xmyoot/smart-bookmark-esp32s3/docs/designBrief.html

# Smart Bookmark voice recorder — rev A

Design brief · press a button, speak, clips sync to a phone over BLE · KiCad 10 · JLCPCB 4-layer + assembly · 2026-10-05

## Status

0 / 0ERC errors / warnings

0 / 0 / 0DRC errors / unconnected / parity

153 / 153datasheet pins verified

37 × 52 mm4-layer, 0.8 mm, parts on one side

about 15 µAstandby, from datasheet figures

builds cleanfirmware, not yet run on hardware

## Board

Top render

Bottom render

Angled render

Top copper

Back side carries no parts: the cell lies in the outlined area; battery pads and test pads sit outside it.

## Architecture

USB-C VBUS --> charger U3 (100 mA) --> +BATT --> regulator U5 --> 3.3 V --> ESP32-S3 module, clip flash U6
                                        |
                        cell + ---------+        cell - --> protection U4/Q1 --> GND

button --> ESP32-S3 <-- PDM microphone (powered from a GPIO)
           ESP32-S3 --> ADPCM clips on flash --> BLE --> phone app

The device sleeps until the button is pressed or USB is plugged in. Holding the button records; on release the clip is stored and the bookmark advertises for 30 s so the phone can fetch it. Protocol: docs/ble_protocol.md.

## Key parts

Ref | Part | LCSC | Role
U1 | ESP32-S3-MINI-1-N8 | C2913206 | MCU + BLE, 8 MB flash, PCB antenna, pre-certified. 15.4 × 20.5 × 2.4 mm
MK1 | TDK T3902 | C3171752 | Bottom-port PDM microphone, powered from GPIO41 so it is fully off in sleep
U6 | W25Q128JVPIQ | C190862 | 16 MB NOR flash for clips, on SPI2
U3 | MCP73832T-2ACI/OT | C38066 | Li-ion charger, 4.20 V, 100 mA set by R3 (10 kΩ)
U4 + Q1 | DW01A + FS8205A | C351410 / C908265 | Cell protection: 4.30 V over-charge, 2.50 V over-discharge, short-circuit
U5 | RT9080-33GJ5 | C841192 | 3.3 V LDO, 600 mA, 2 µA quiescent
J1 + U2 | HRO TYPE-C-31-M-12 + USBLC6-2SC6 | C165948 / C7519 | USB-C: charging, native USB flashing and logs, ESD protection
Q2 + Q3 | AO3401A + 2N7002 | C15127 / C8545 | Battery-sense divider switch: no divider current in sleep
SW1 / D1 | TS-1088-AR02016 / KT-0603R | C720477 / C2286 | Record button (2.0 mm tall) and red status LED

## Pin map

Pin | Function | Note
GPIO1 | Record button | To GND, internal pull-up, wakes the chip. Same pin as the XIAO prototype (D0)
GPIO2 | Status LED | Active high. Same pin as the XIAO prototype (D1)
GPIO5 | Battery voltage | ADC1, half the cell voltage while GPIO16 is high
GPIO16 / 17 / 18 | Battery-sense enable / charging / USB present | USB plug-in can wake the chip
GPIO10–13 | Clip flash U6 | MISO, CS, SCK, MOSI
GPIO19 / 20 | USB D− / D+ | Native USB
GPIO40 / 41 / 42 | Mic data / mic power / mic clock
GPIO0, EN, GPIO43 / 44 | BOOT, reset, UART | Test pads on the back

## Power budget

Item | Current
ESP32-S3 module, deep sleep with wake armed | 8 µA
Regulator U5 | 2 µA
Protection U4 | 3 µA
Flash U6 in deep power-down (to be verified) | about 1 µA
Charger leakage, mic, divider, LED | about 0
Standby total | about 15 µA
Recording (estimate) | about 40 mA
BLE transfer (estimate) | about 80 mA

Ten 20-second clips and one sync a day is roughly 3.5 mAh, so a 150 mAh cell lasts about six weeks of daily use. Standby alone is limited by the cell's self-discharge, not the board.

## Engineering decisions

Topic | Decision
Module, not bare chip | The ESP32-S3-MINI-1 keeps the client's S3 firmware base and hardware PDM decoding, is 2.4 mm tall, and brings its radio certification to a 500-unit run. ESP32-C3/C6 cannot decode a PDM microphone in hardware; nRF52840 would mean rewriting working firmware.
No SD card | Clips are IMA ADPCM (8 kB/s) on flash. That removes the tallest, most power-hungry prototype part and makes BLE sync four times faster than raw audio.
No power-path switch | The load sits on the cell, as on the XIAO. An OR-ing Schottky would leak more in standby than the rest of the board draws. Firmware sleeps when idle on USB so charging can terminate.
Pins chosen for the layout | Each signal group leaves the module on the side its parts sit on, so the top layer has no crossings. Only five signals use the back.
Height, not area, is tight | 0.8 mm board + 2.4 mm module + 2.5 mm cell = 5.7 mm of an assumed 6.0 mm. The USB-C connector is 3.3 mm tall, so the cell is kept clear of it.
Module sits 0.45 mm lower than its outline suggests | The real module is 20.5 mm long; KiCad's footprint draws 20.1 mm. Placed so the real part stays on the board.
Microphone land pattern corrected | The imported footprint had a plated port hole and an unconnected four-piece ground ring. The hole is non-plated and the ring is tied to ground.

## Open items

- Enclosure CAD: every mechanical position (USB-C, button, microphone hole, LED, cell) is an assumption until it arrives.
- Firmware compiles but has never run on hardware. The microphone's left/right slot setting is the likeliest first fix.
- CPL rotations are not checked in JLCPCB's preview; Gerbers were not opened in a viewer.
- The microphone 3D model is a same-size stand-in; compare the land pattern with the T3902 datasheet drawing.
- Active-current and battery-life figures are estimates to be measured on the first boards.

## Deliverables

KiCad sources and generator scripts; Gerber zip, JLCPCB BOM and pick-and-place, schematic and assembly PDFs and a 3D STEP file; ESP-IDF firmware source; BLE protocol, design spec, reference circuits and a bring-up checklist.
