xmyoot/smart-bookmark-esp32s3/docs/placement_back.png

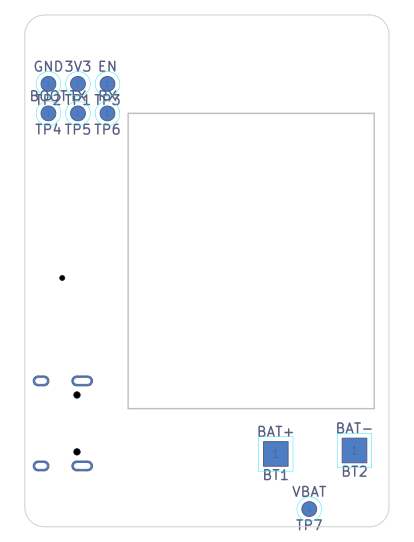
docs/placement_back.png
