xmyoot/smart-bookmark-esp32s3/docs/placement_top.png

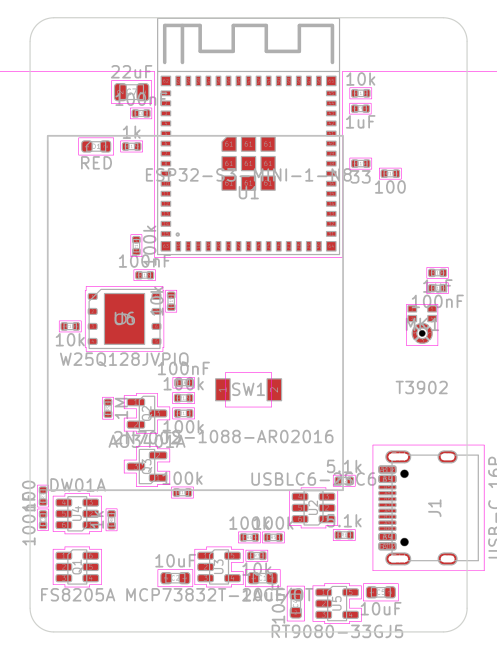
docs/placement_top.png
