xmyoot/smart-bookmark-esp32s3/docs/route_bot.png

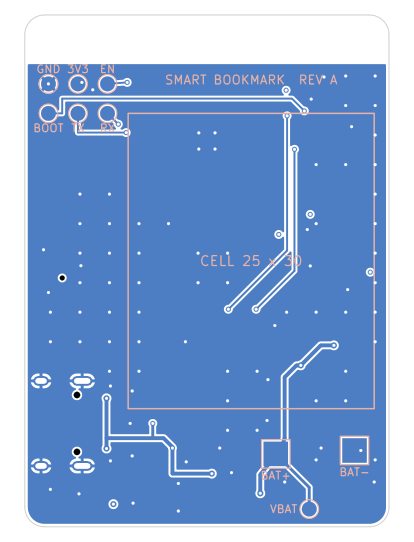
docs/route_bot.png
