xmyoot/smart-bookmark-esp32s3/docs/route_top.png

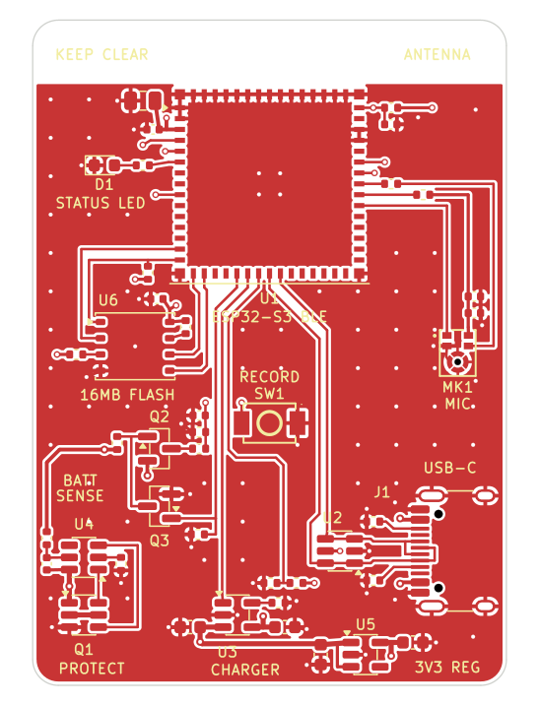
docs/route_top.png
