xmyoot/smart-bookmark-esp32s3/fab/BOM_full.csv

Qty | Designators | Value | Manufacturer part number | LCSC | Footprint
4 | C1 C2 C4 C5 | 10uF | CL10A106KP8NNNC | C19702 | Capacitor_SMD:C_0603_1608Metric
5 | C3 C6 C8 C11 C12 | 100nF | CL05B104KO5NNNC | C1525 | Capacitor_SMD:C_0402_1005Metric
1 | C7 | 22uF | CL21A226MAQNNNE | C45783 | Capacitor_SMD:C_0805_2012Metric
2 | C9 C10 | 1uF | CL05A105KA5NQNC | C52923 | Capacitor_SMD:C_0402_1005Metric
1 | D1 | RED | KT-0603R | C2286 | LED_SMD:LED_0603_1608Metric
1 | J1 | USB-C 16P | TYPE-C-31-M-12 | C165948 | Connector_USB:USB_C_Receptacle_HRO_TYPE-C-31-M-12
1 | MK1 | T3902 | MMICT390200012 | C3171752 | bookmark:MIC-SMD_5P-L3.5-W2.7-TL_MMICT390200012
1 | Q1 | FS8205A | FS8205A | C908265 | Package_TO_SOT_SMD:SOT-23-6
1 | Q2 | AO3401A | AO3401A | C15127 | Package_TO_SOT_SMD:SOT-23
1 | Q3 | 2N7002 | 2N7002 | C8545 | Package_TO_SOT_SMD:SOT-23
2 | R1 R2 | 5.1k | 0402WGF5101TCE | C25905 | Resistor_SMD:R_0402_1005Metric
4 | R3 R13 R18 R19 | 10k | 0402WGF1002TCE | C25744 | Resistor_SMD:R_0402_1005Metric
6 | R5 R6 R10 R11 R12 R16 | 100k | 0402WGF1003TCE | C25741 | Resistor_SMD:R_0402_1005Metric
2 | R7 R14 | 100 | 0402WGF1000TCE | C25076 | Resistor_SMD:R_0402_1005Metric
2 | R8 R17 | 1k | 0402WGF1001TCE | C11702 | Resistor_SMD:R_0402_1005Metric
1 | R9 | 1M | 0402WGF1004TCE | C26083 | Resistor_SMD:R_0402_1005Metric
1 | R15 | 33 | 0402WGF330JTCE | C25105 | Resistor_SMD:R_0402_1005Metric
1 | SW1 | TS-1088-AR02016 | TS-1088-AR02016 | C720477 | bookmark:SW-SMD_L3.9-W3.0-P4.45
1 | U1 | ESP32-S3-MINI-1-N8 | ESP32-S3-MINI-1-N8 | C2913206 | RF_Module:ESP32-S2-MINI-1
1 | U2 | USBLC6-2SC6 | USBLC6-2SC6 | C7519 | Package_TO_SOT_SMD:SOT-23-6
1 | U3 | MCP73832T-2ACI/OT | MCP73832T-2ACI/OT | C38066 | Package_TO_SOT_SMD:SOT-23-5
1 | U4 | DW01A | DW01A | C351410 | Package_TO_SOT_SMD:SOT-23-6
1 | U5 | RT9080-33GJ5 | RT9080-33GJ5 | C841192 | Package_TO_SOT_SMD:TSOT-23-5
1 | U6 | W25Q128JVPIQ | W25Q128JVPIQ | C190862 | Package_SON:WSON-8-1EP_6x5mm_P1.27mm_EP3.4x4.3mm
