xmyoot/smart-bookmark-esp32s3/fab/smart-bookmark-esp32s3.step

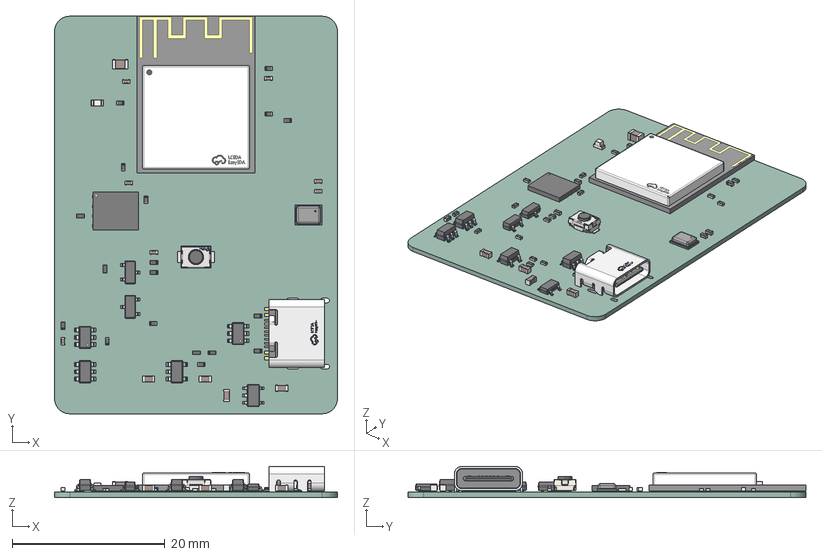
[picture p8: CAD file, 2026-10-05]
fab/smart-bookmark-esp32s3.step
37.0 x 52.0 x 4.10 mm
R_0402_1005Metric x 18
C_0603_1608Metric x 4
LED_0603_1608Metric
SOT-23-6 x 3
SW-SMD_L3.9-W2.9-H2.0-LS4.8
Knowles_SPH0645LM4H-6_3.5x2.65mm
C_0402_1005Metric x 7
SOT-23 x 2
BULETM-SMD_ESP32-S3-MINI-1-N8
WSON-8-1EP_6x5mm_P1.27mm_EP3.4x4.3mm
TSOT-23-5
SOT-23-5
USB-C_SMD-TYPE-C-31-M-12
C_0805_2012Metric
smart-bookmark-esp32s3_PCB
