xmyoot/smart-bookmark-esp32s3/fab/smart-bookmark-esp32s3_assembly_bottom.pdf

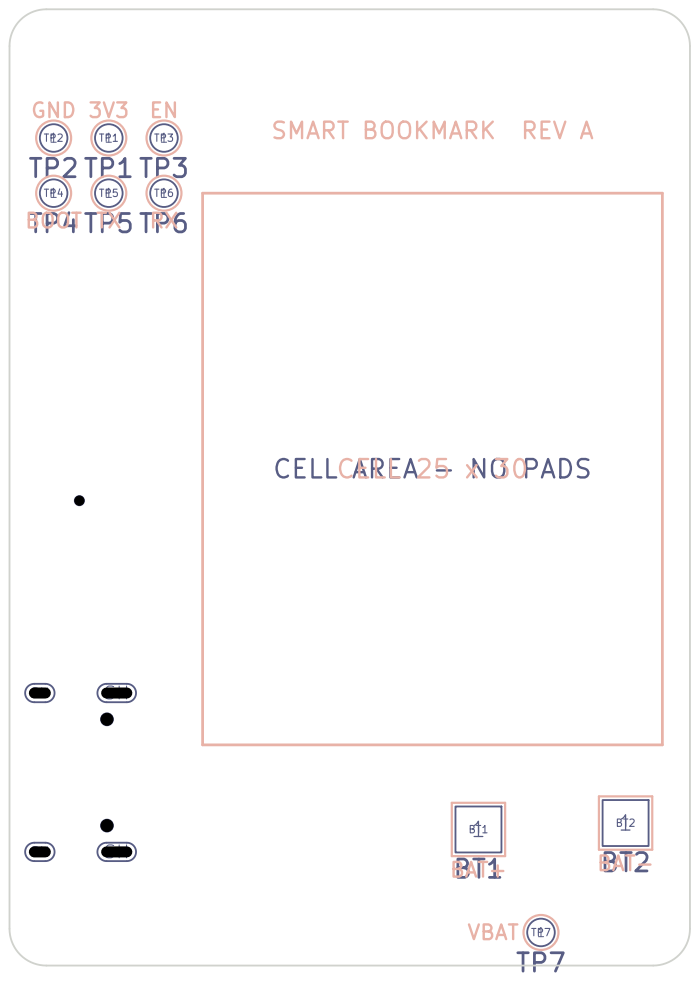
[picture p9: page 1]

CELL AREA - NO PADS

Size: A4 | Rev:
KiCad E.D.A. 10.0.5 | Id: 1/1
