xmyoot/smart-bookmark-esp32s3/fab/smart-bookmark-esp32s3_assembly_top.pdf

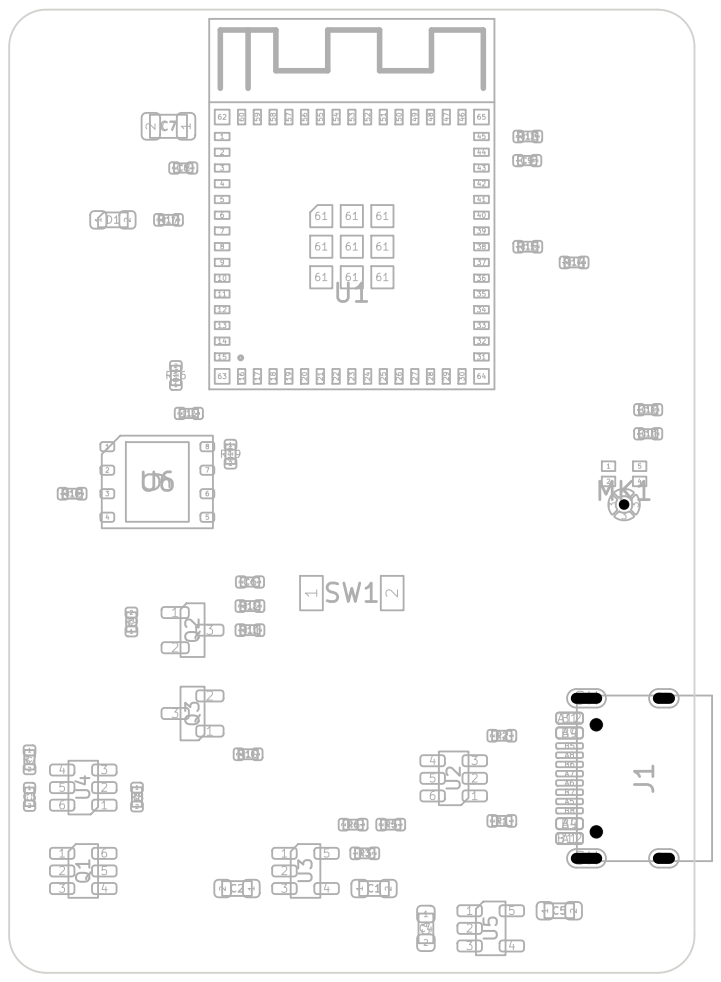
[picture p10: page 1]

Size: A4 | Rev:
KiCad E.D.A. 10.0.5 | Id: 1/3

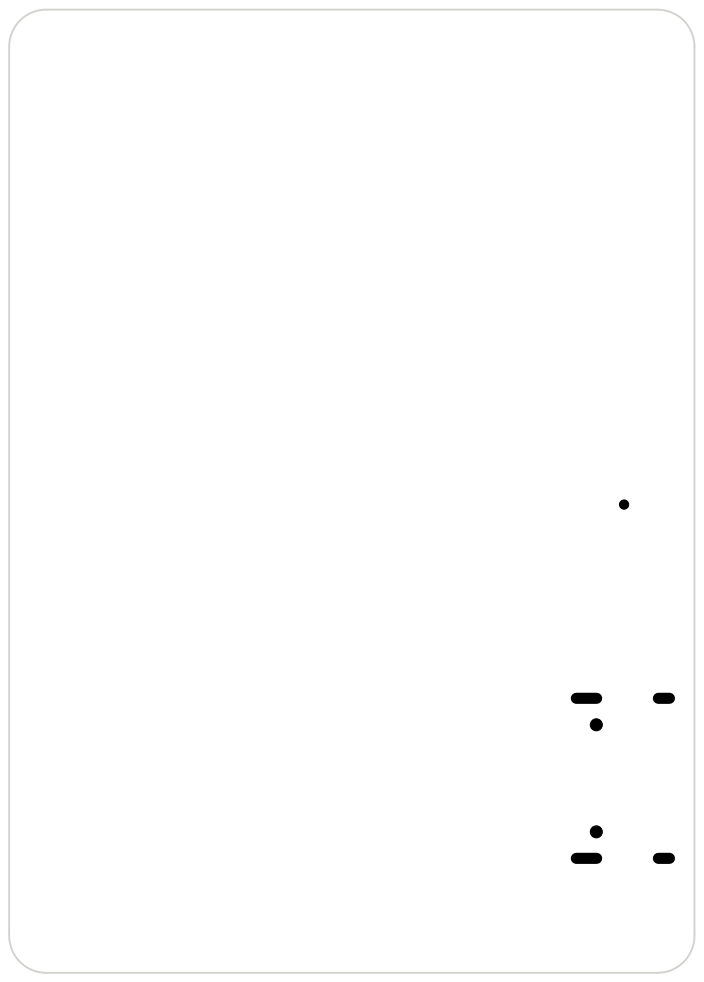
[picture p11: page 2]

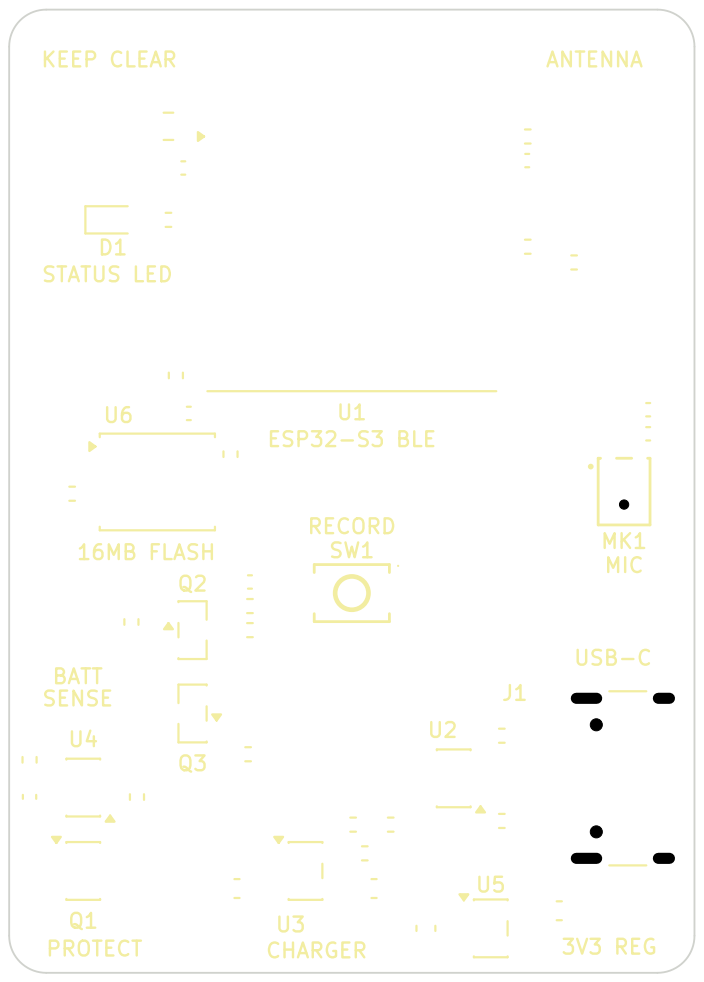
[picture p12: page 3]

KEEP CLEAR
BATT SENSE PROTECT STATUS LED

ANTENNA 3V3 REG USB-C MIC
