xmyoot/smart-bookmark-esp32s3/fab/smart-bookmark-esp32s3_schematic.pdf

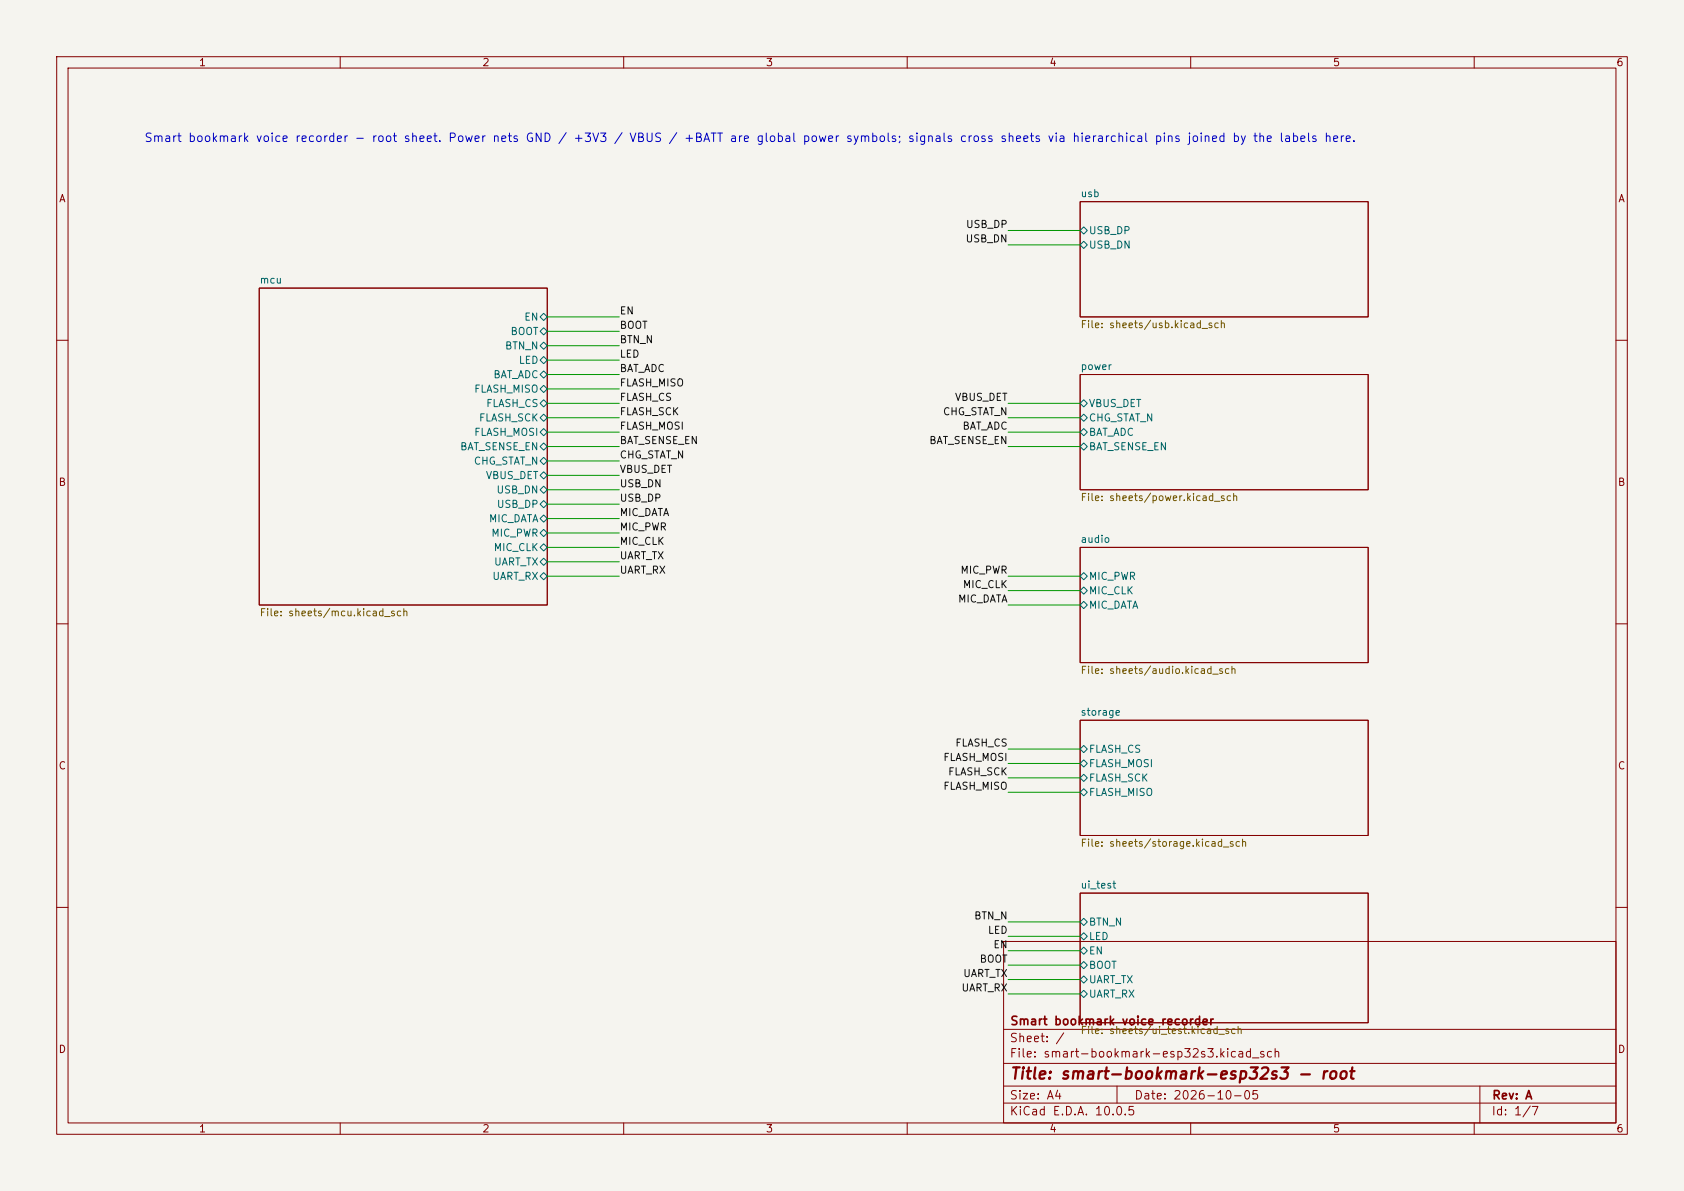
[picture p13: page 1]

Smart bookmark voice recorder - root sheet. Power nets GND / +3V3 / VBUS / +BATT are global power symbols; signals cross sheets via hierarchical pins joined by the labels here.

power File: sheets/power.kicad_sch MIC_PWR MIC_CLK MIC_DATA audio

Smart bookmark voice recorder
Sheet: /
File: smart-bookmark-esp32s3.kicad_sch
Title: smart-bookmark-esp32s3 - root

Size: A4 | Rev: A
KiCad E.D.A. 10.0.5 | Id: 1/7

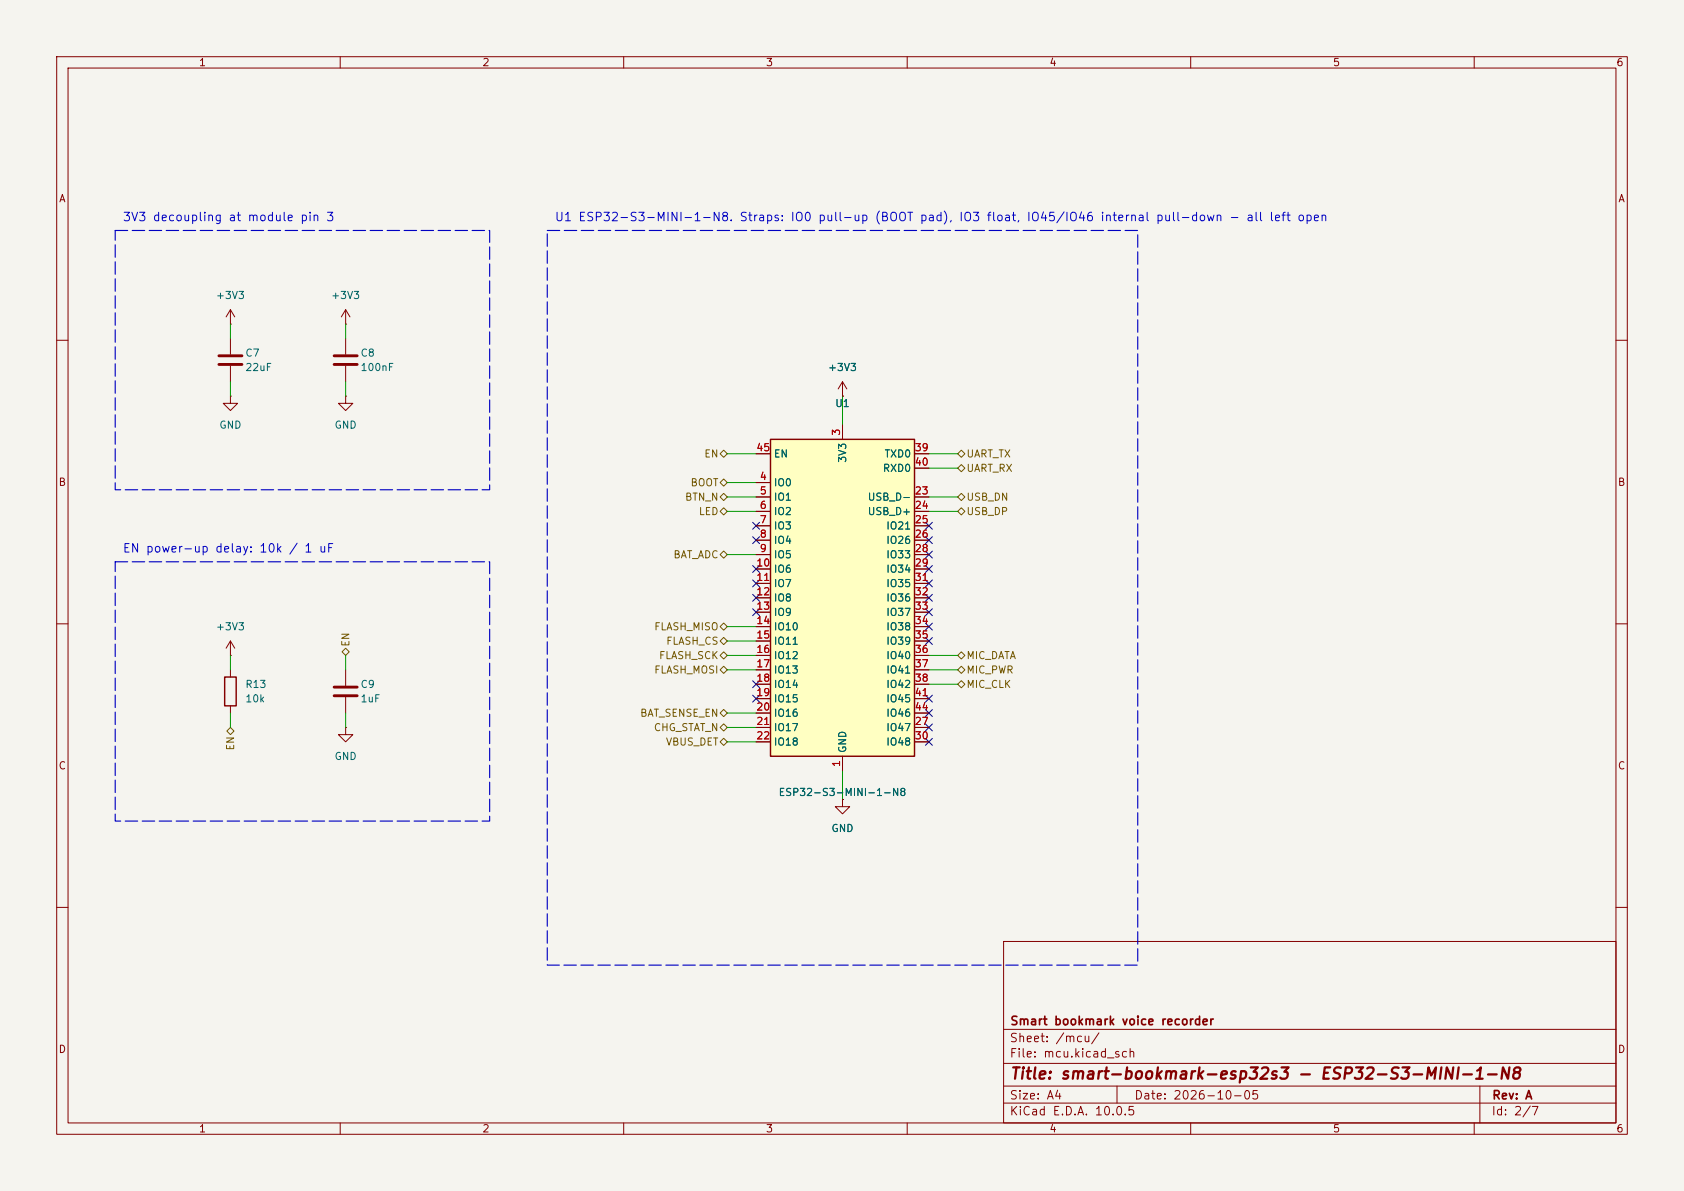
[picture p14: page 2]

FLASH_MOSI U1 ESP32-S3-MINI-1-N8. Straps: IO0 pull-up (BOOT pad), IO3 float, IO45/IO46 internal pull-down - all left open

EN power-up delay: 10k / 1 uF

Smart bookmark voice recorder
Sheet: /mcu/
File: mcu.kicad_sch
Title: smart-bookmark-esp32s3 - ESP32-S3-MINI-1-N8

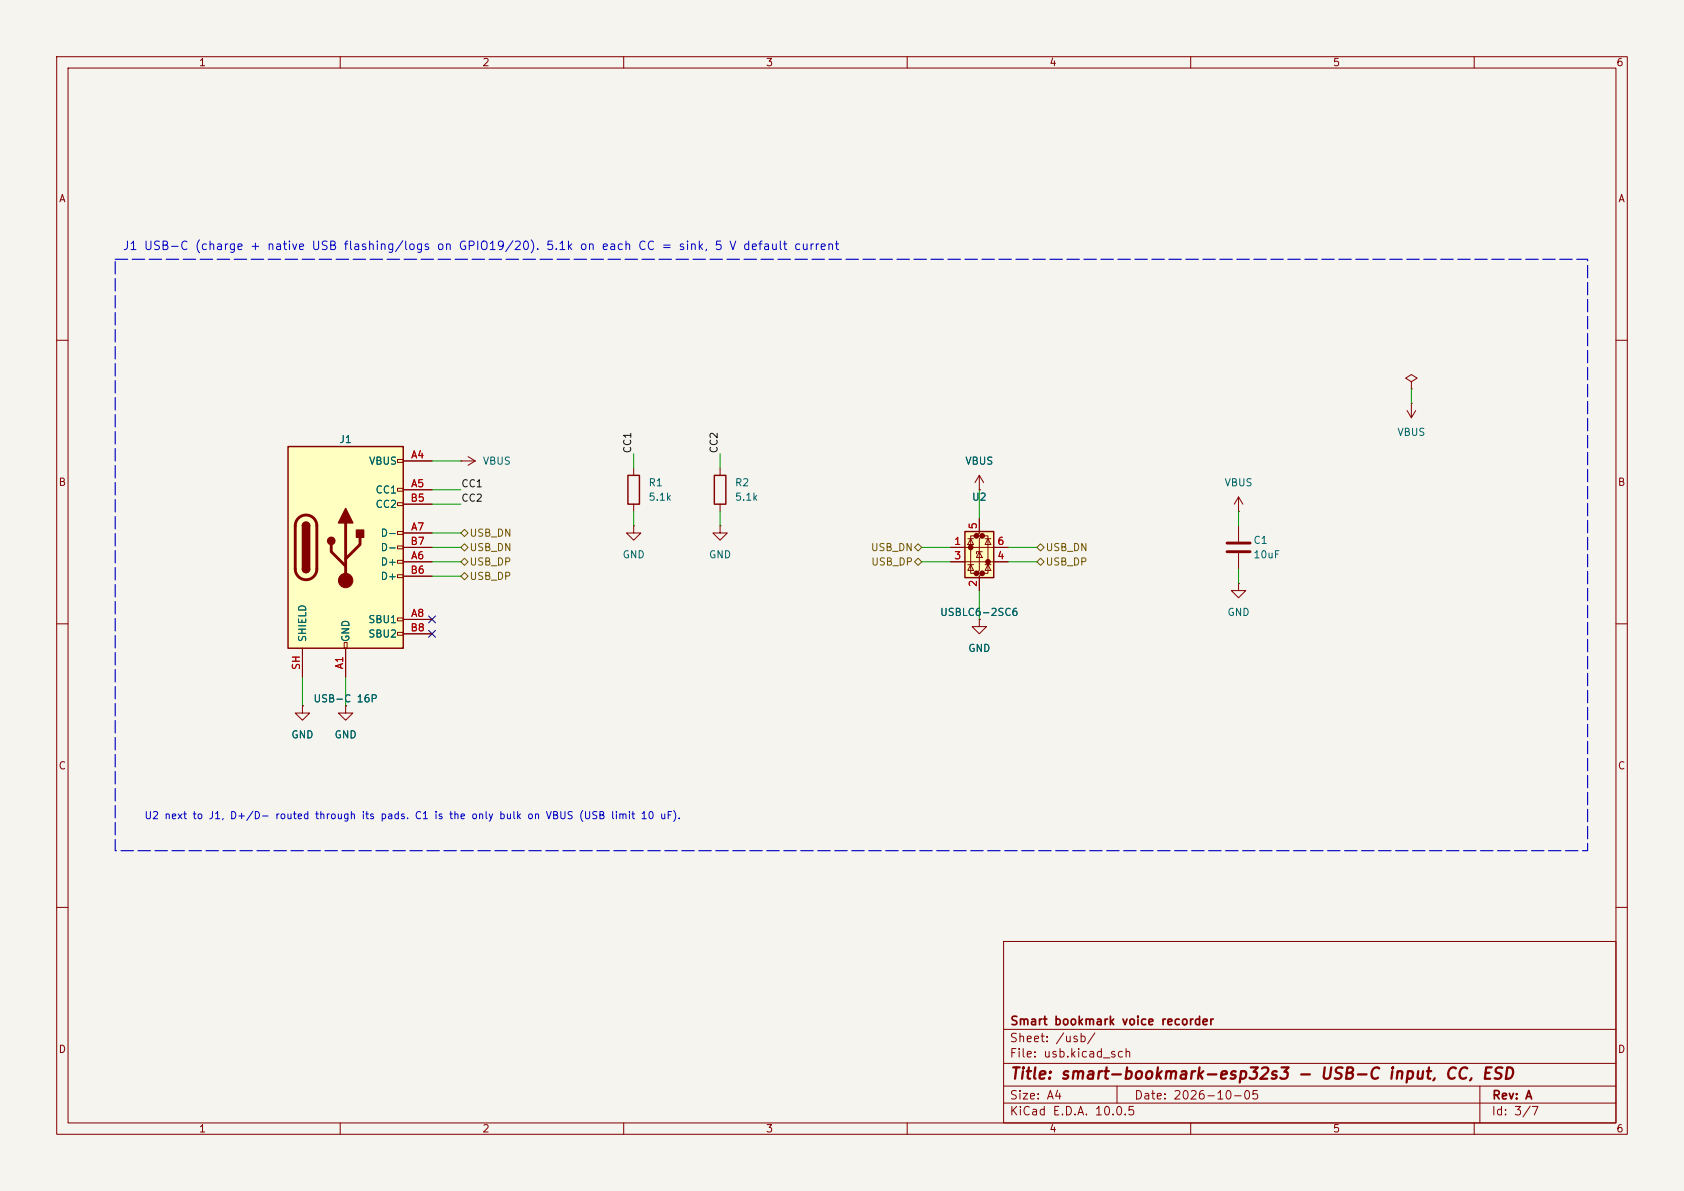
[picture p15: page 3]

J1 USB-C (charge + native USB flashing/logs on GPIO19/20). 5.1k on each CC = sink, 5 V default current U2 next to J1, D+/D- routed through its pads. C1 is the only bulk on VBUS (USB limit 10 uF). J1 USB-C 16P GND A1

Smart bookmark voice recorder GND

Sheet: /usb/
File: usb.kicad_sch
Title: smart-bookmark-esp32s3 - USB-C input, CC, ESD

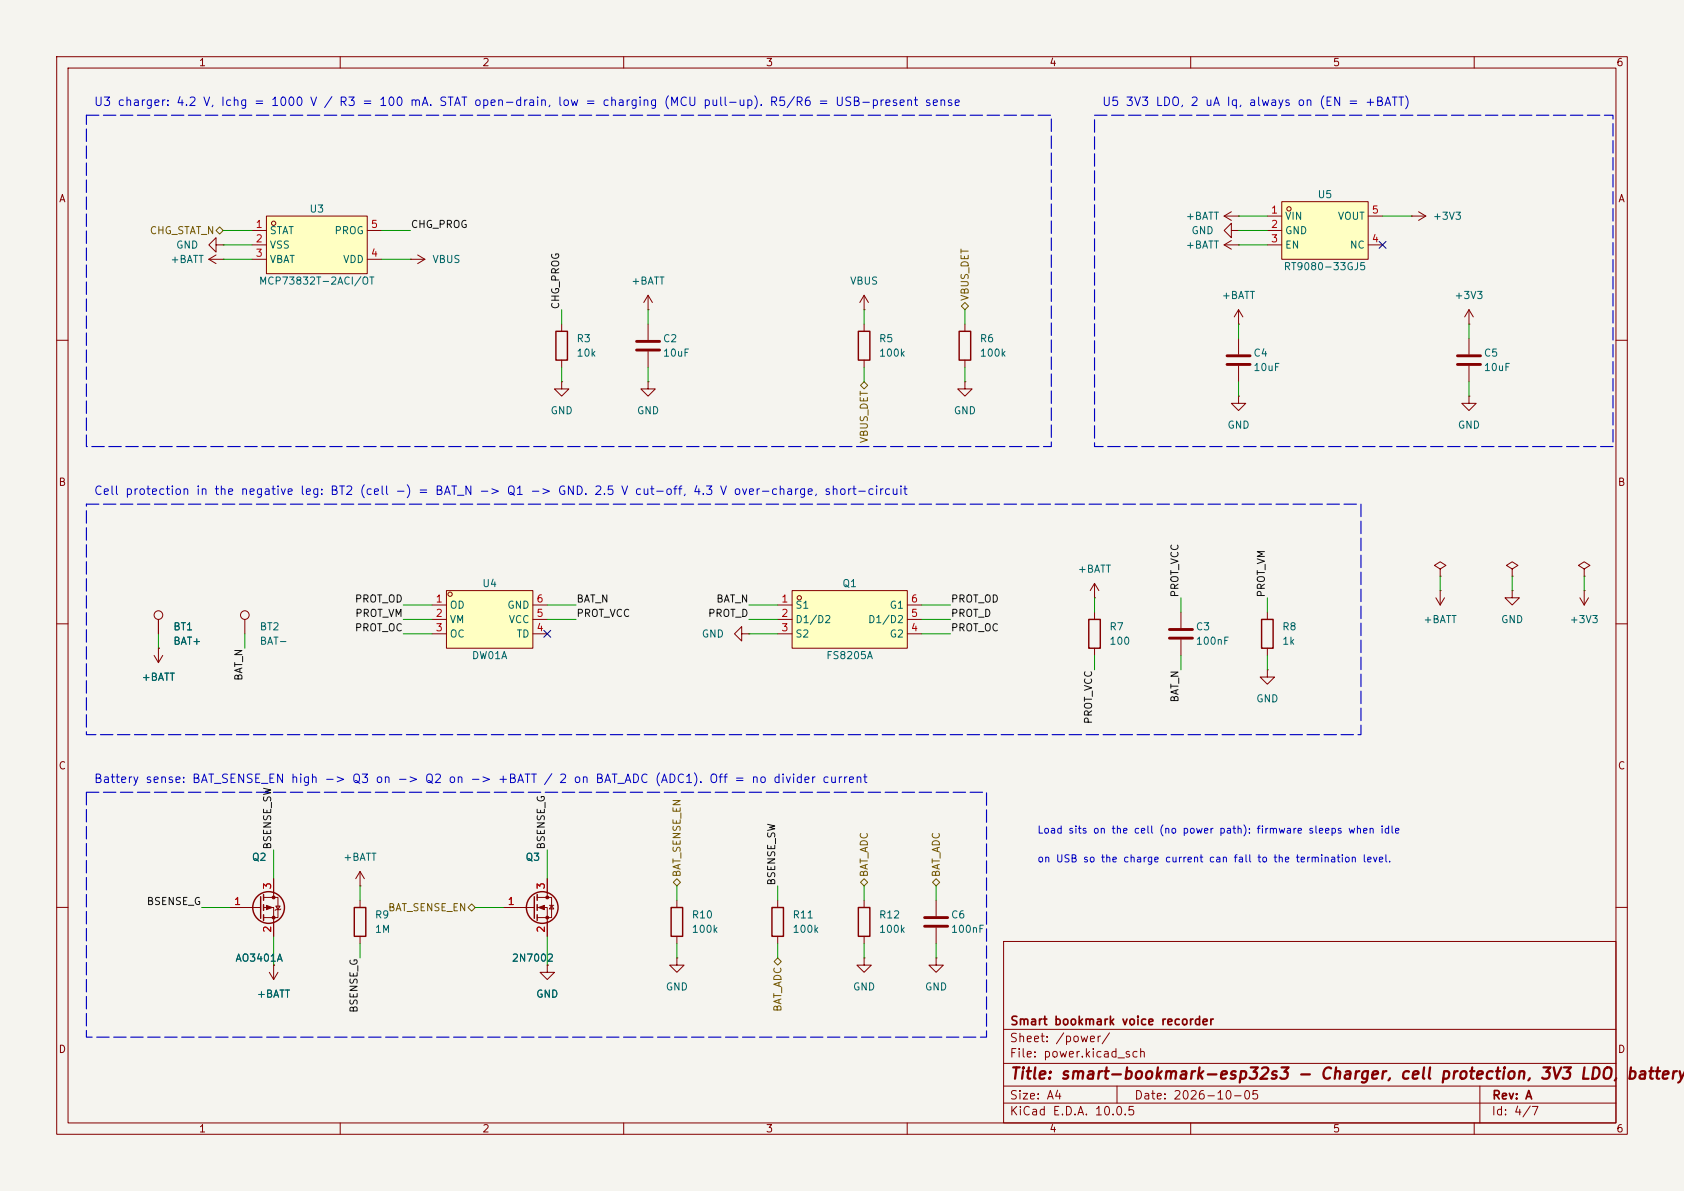
[picture p16: page 4]

U3 charger: 4.2 V, Ichg = 1000 V / R3 = 100 mA. STAT open-drain, low = charging (MCU pull-up). R5/R6 = USB-present sense

U5 3V3 LDO, 2 uA Iq, always on (EN = +BATT)
VSS 2
VBAT 3

PROT_VCC Cell protection in the negative leg: BT2 (cell -) = BAT_N -> Q1 -> GND. 2.5 V cut-off, 4.3 V over-charge, short-circuit

Smart bookmark voice recorder R9

Sheet: /power/
File: power.kicad_sch
Title: smart-bookmark-esp32s3 - Charger, cell protection, 3V3 LDO, battery sense

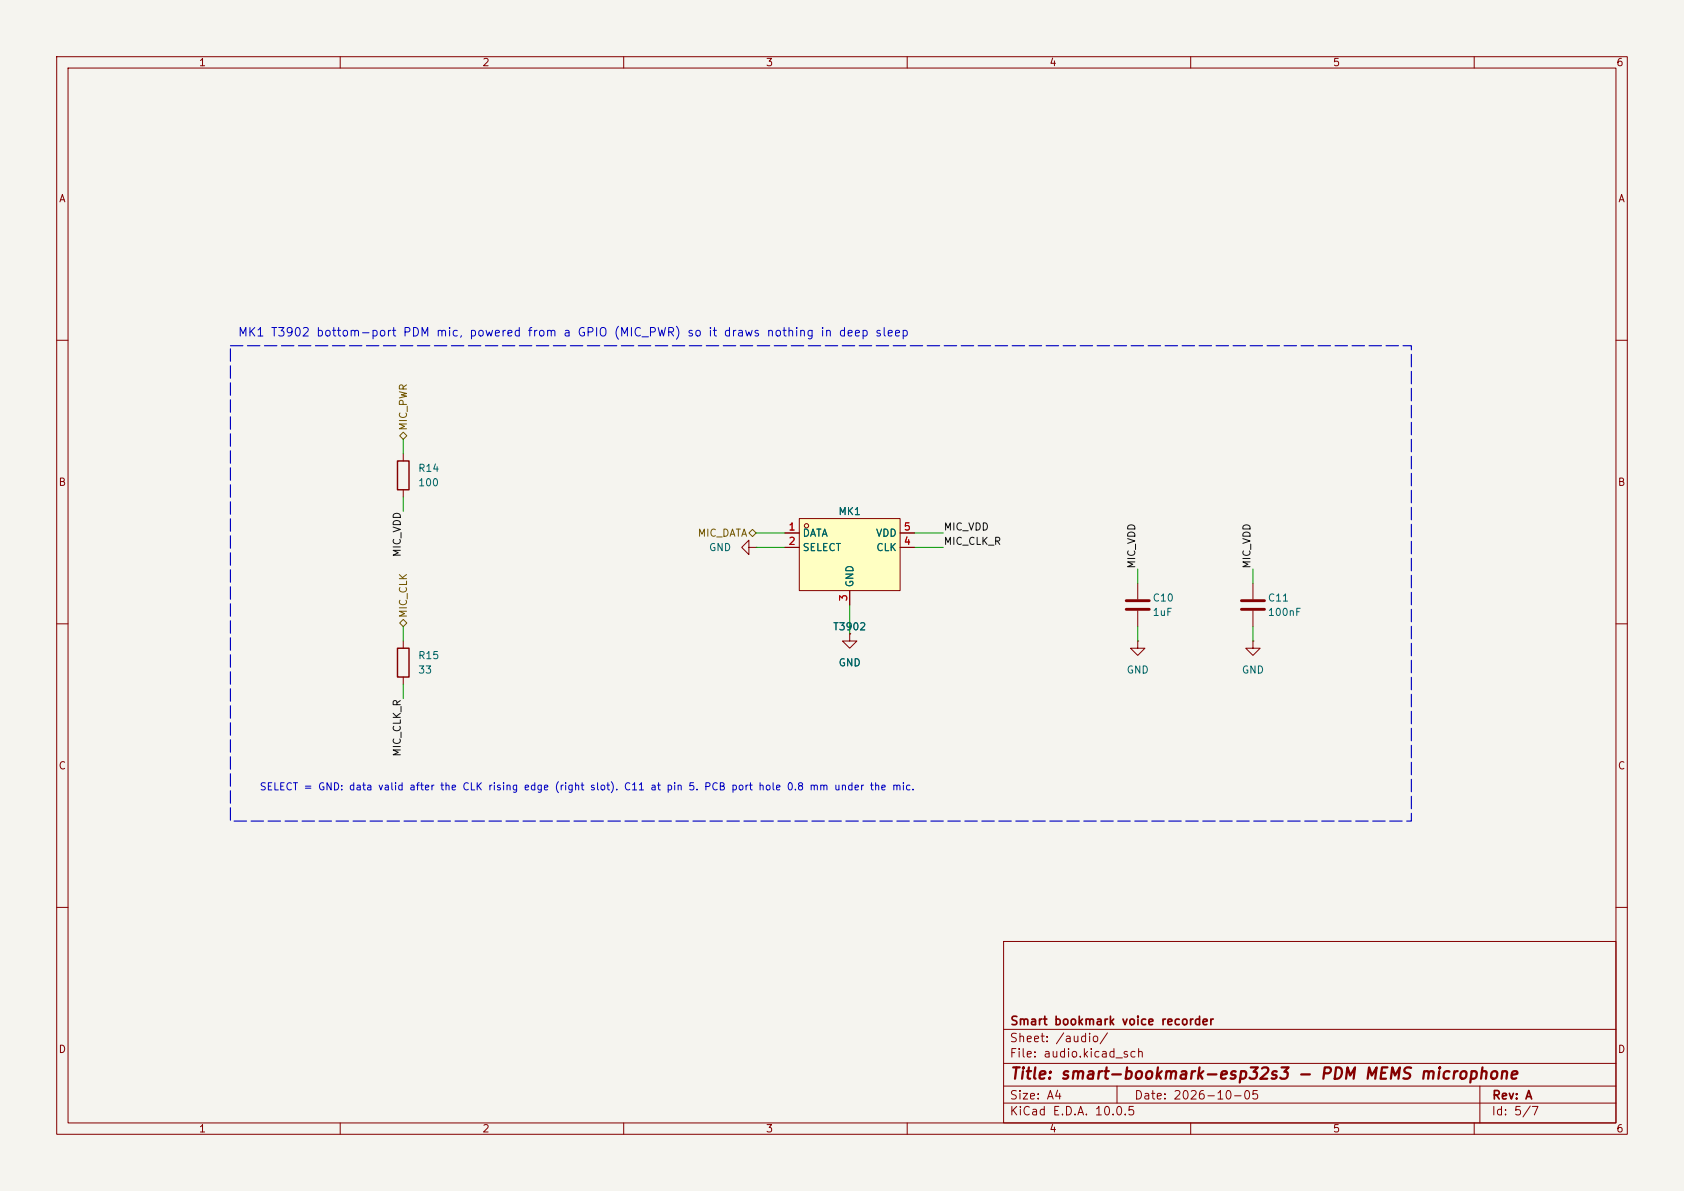
[picture p17: page 5]

MK1 T3902 bottom-port PDM mic, powered from a GPIO (MIC_PWR) so it draws nothing in deep sleep

SELECT = GND: data valid after the CLK rising edge (right slot). C11 at pin 5. PCB port hole 0.8 mm under the mic. MK1

Sheet: /audio/
File: audio.kicad_sch
Title: smart-bookmark-esp32s3 - PDM MEMS microphone

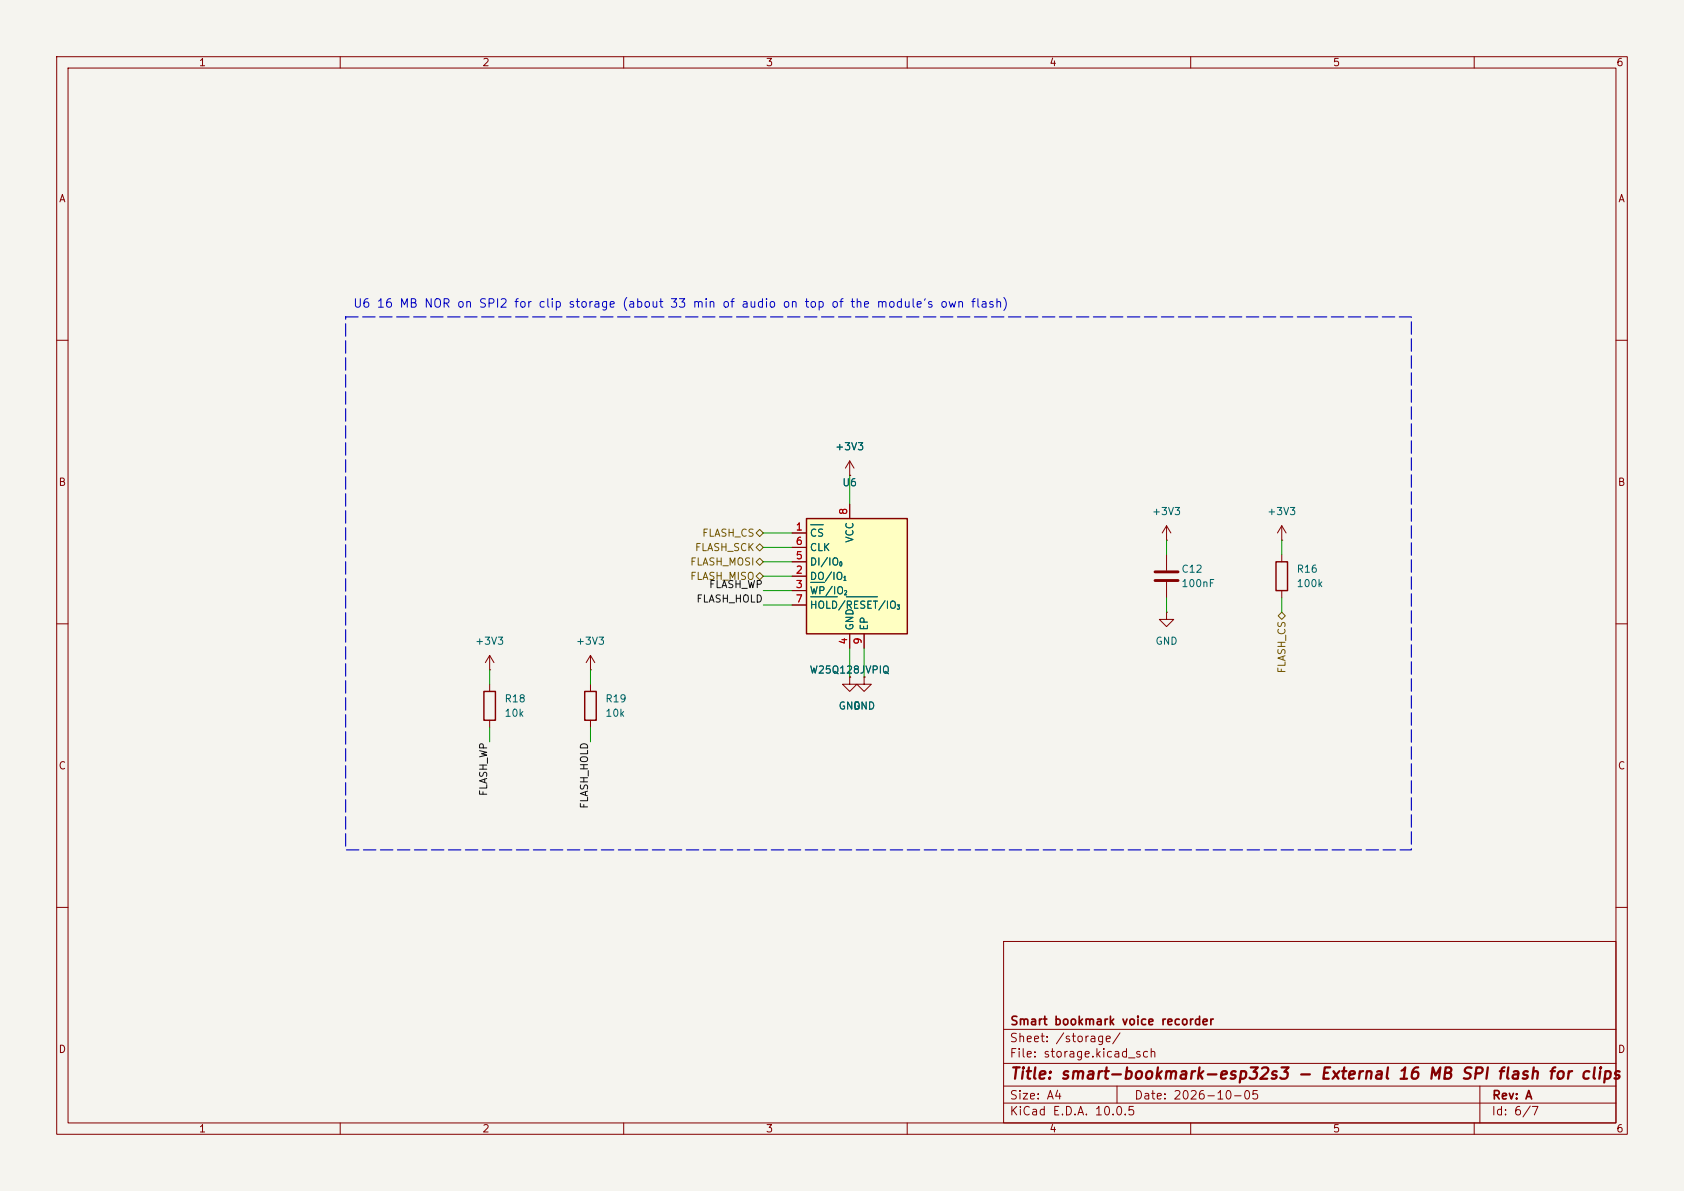
[picture p18: page 6]

U6 16 MB NOR on SPI2 for clip storage (about 33 min of audio on top of the module's own flash) U6 W25Q128JVPIQ

4 DI/IO0 5 CLK 6 HOLD/RESET/IO3 7 VCC

Smart bookmark voice recorder GND R19

Sheet: /storage/
File: storage.kicad_sch
Title: smart-bookmark-esp32s3 - External 16 MB SPI flash for clips

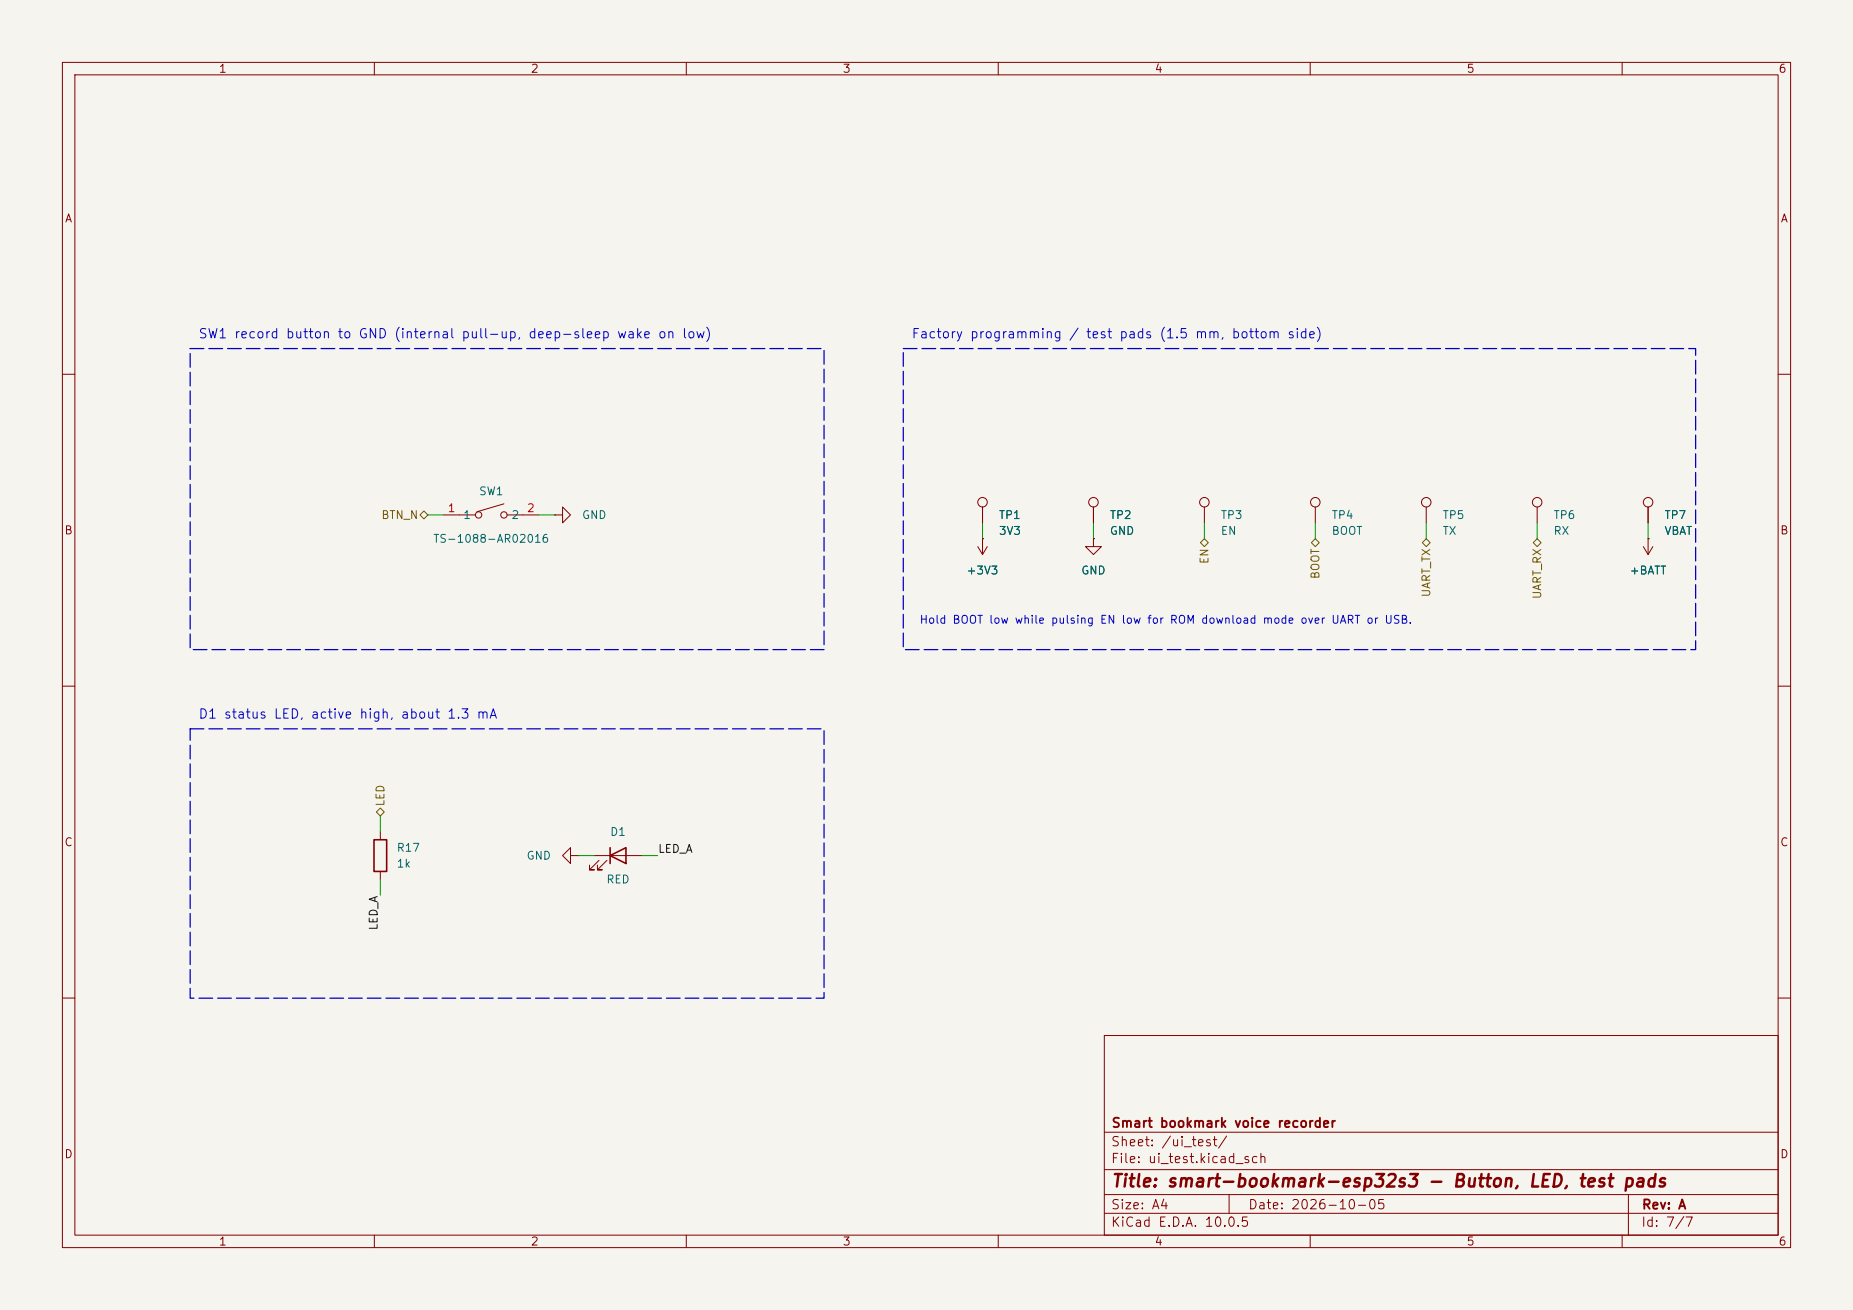
[picture p19: page 7]

Smart bookmark voice recorder
Sheet: /ui_test/
File: ui_test.kicad_sch
Title: smart-bookmark-esp32s3 - Button, LED, test pads
