xmyoot/smart-bookmark-esp32s3/smart-bookmark-esp32s3.kicad_pcb

## KiCad design smart-bookmark-esp32s3.kicad_pcb (2026-10-05)

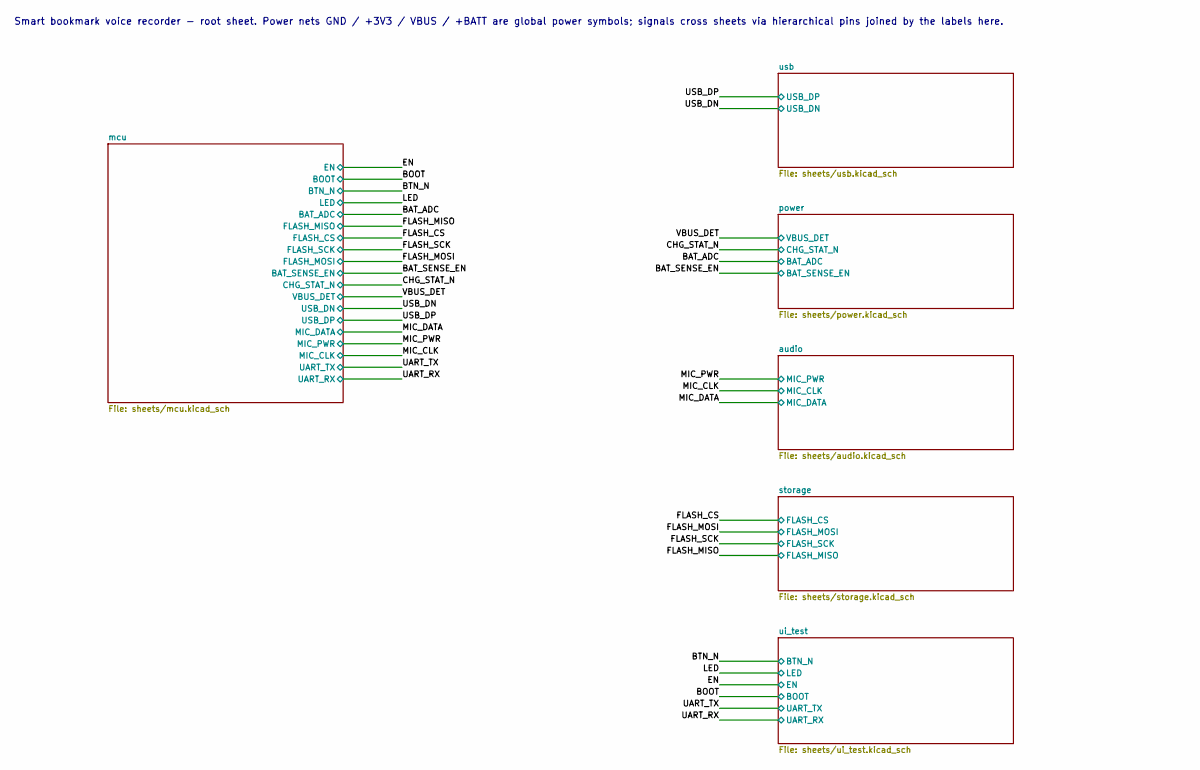
[picture p20: schematic smart-bookmark-esp32s3.kicad_sch, smart-bookmark-esp32s3 - root]

Notes on the sheet:
Smart bookmark voice recorder - root sheet. Power nets GND / +3V3 / VBUS / +BATT are global power symbols; signals cross sheets via hierarchical pins joined by the labels here.

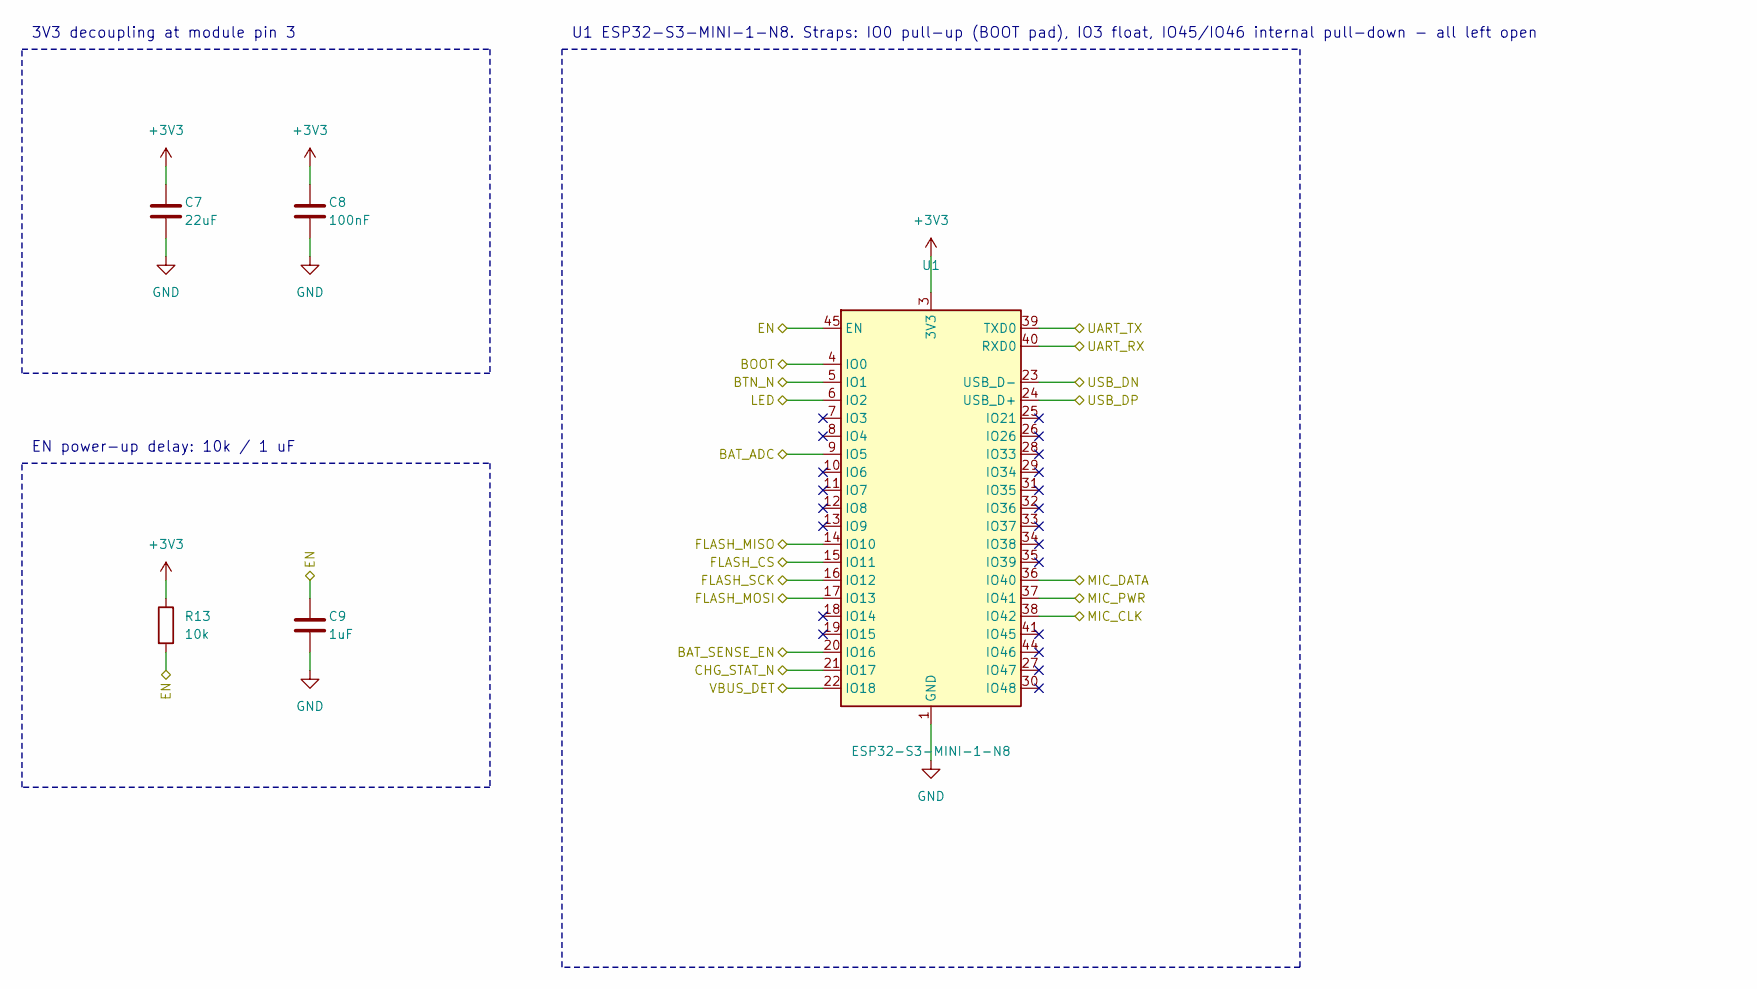
[picture p21: schematic mcu.kicad_sch, smart-bookmark-esp32s3 - ESP32-S3-MINI-1-N8]

Parts:
C7: 22uF; C_0805_2012Metric; MPN CL21A226MAQNNNE; LCSC C45783
C8: 100nF; C_0402_1005Metric; MPN CL05B104KO5NNNC; LCSC C1525
C9: 1uF; C_0402_1005Metric; MPN CL05A105KA5NQNC; LCSC C52923
R13: 10k; R_0402_1005Metric; MPN 0402WGF1002TCE; LCSC C25744
U1: ESP32-S3-MINI-1-N8; ESP32-S2-MINI-1; MPN ESP32-S3-MINI-1-N8; LCSC C2913206

Connections:
+3V3: C7.1, C8.1, R13.1, U1.3 (3V3); also elsewhere on the board
/BAT_ADC: U1.9 (IO5); also elsewhere on the board
/BAT_SENSE_EN: U1.20 (IO16); also elsewhere on the board
/BOOT: U1.4 (IO0); also elsewhere on the board
/BTN_N: U1.5 (IO1); also elsewhere on the board
/CHG_STAT_N: U1.21 (IO17); also elsewhere on the board
/EN: C9.1, R13.2, U1.45 (EN); also elsewhere on the board
/FLASH_CS: U1.15 (IO11); also elsewhere on the board
/FLASH_MISO: U1.14 (IO10); also elsewhere on the board
/FLASH_MOSI: U1.17 (IO13); also elsewhere on the board
/FLASH_SCK: U1.16 (IO12); also elsewhere on the board
/LED: U1.6 (IO2); also elsewhere on the board
/MIC_CLK: U1.38 (IO42); also elsewhere on the board
/MIC_DATA: U1.36 (IO40); also elsewhere on the board
/MIC_PWR: U1.37 (IO41); also elsewhere on the board
/UART_RX: U1.40 (RXD0); also elsewhere on the board
/UART_TX: U1.39 (TXD0); also elsewhere on the board
/USB_DN: U1.23 (USB_D-); also elsewhere on the board
/USB_DP: U1.24 (USB_D+); also elsewhere on the board
/VBUS_DET: U1.22 (IO18); also elsewhere on the board
GND: C7.2, C8.2, C9.2, U1.1 (GND), U1.2 (GND), U1.42 (GND), U1.43 (GND), U1.46 (GND), U1.47 (GND), U1.48 (GND), U1.49 (GND), U1.50 (GND), U1.51 (GND), U1.52 (GND), U1.53 (GND), U1.54 (GND), U1.55 (GND), U1.56 (GND), U1.57 (GND), U1.58 (GND), U1.59 (GND), U1.60 (GND), U1.61 (GND), U1.62 (GND), U1.63 (GND), U1.64 (GND), U1.65 (GND); also elsewhere on the board

Notes on the sheet:
U1 ESP32-S3-MINI-1-N8. Straps: IO0 pull-up (BOOT pad), IO3 float, IO45/IO46 internal pull-down - all left open
3V3 decoupling at module pin 3
EN power-up delay: 10k / 1 uF

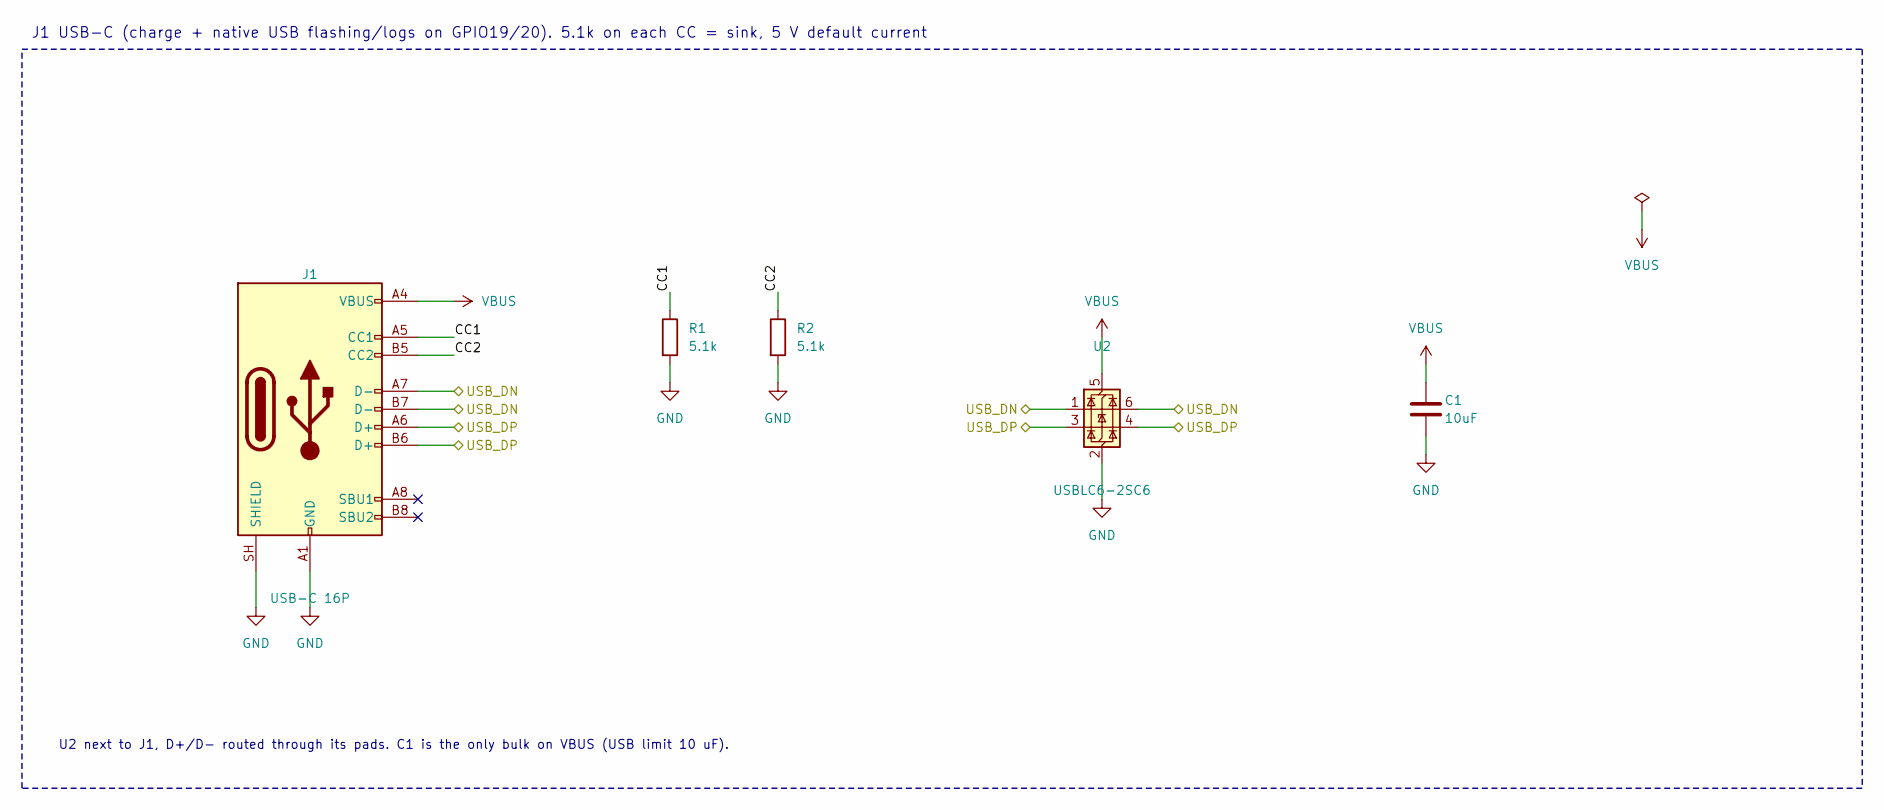
[picture p22: schematic usb.kicad_sch, smart-bookmark-esp32s3 - USB-C input, CC, ESD]

Parts:
C1: 10uF; C_0603_1608Metric; MPN CL10A106KP8NNNC; LCSC C19702
J1: USB-C 16P; USB_C_Receptacle_HRO_TYPE-C-31-M-12; MPN TYPE-C-31-M-12; LCSC C165948
R1, R2: 5.1k; R_0402_1005Metric; MPN 0402WGF5101TCE; LCSC C25905
U2: USBLC6-2SC6; SOT-23-6; MPN USBLC6-2SC6; LCSC C7519

Connections:
/USB_DN: J1.A7 (D-), J1.B7 (D-), U2.1 (I/O1), U2.6 (I/O1); also elsewhere on the board
/USB_DP: J1.A6 (D+), J1.B6 (D+), U2.3 (I/O2), U2.4 (I/O2); also elsewhere on the board
/usb/CC1: J1.A5 (CC1), R1.1
/usb/CC2: J1.B5 (CC2), R2.1
GND: C1.2, J1.A1 (GND), J1.A12 (GND), J1.B1 (GND), J1.B12 (GND), J1.SH (SHIELD), R1.2, R2.2, U2.2 (GND); also elsewhere on the board
VBUS: C1.1, J1.A4 (VBUS), J1.A9 (VBUS), J1.B4 (VBUS), J1.B9 (VBUS), U2.5 (VBUS); also elsewhere on the board

Notes on the sheet:
J1 USB-C (charge + native USB flashing/logs on GPIO19/20). 5.1k on each CC = sink, 5 V default current
U2 next to J1, D+/D- routed through its pads. C1 is the only bulk on VBUS (USB limit 10 uF).

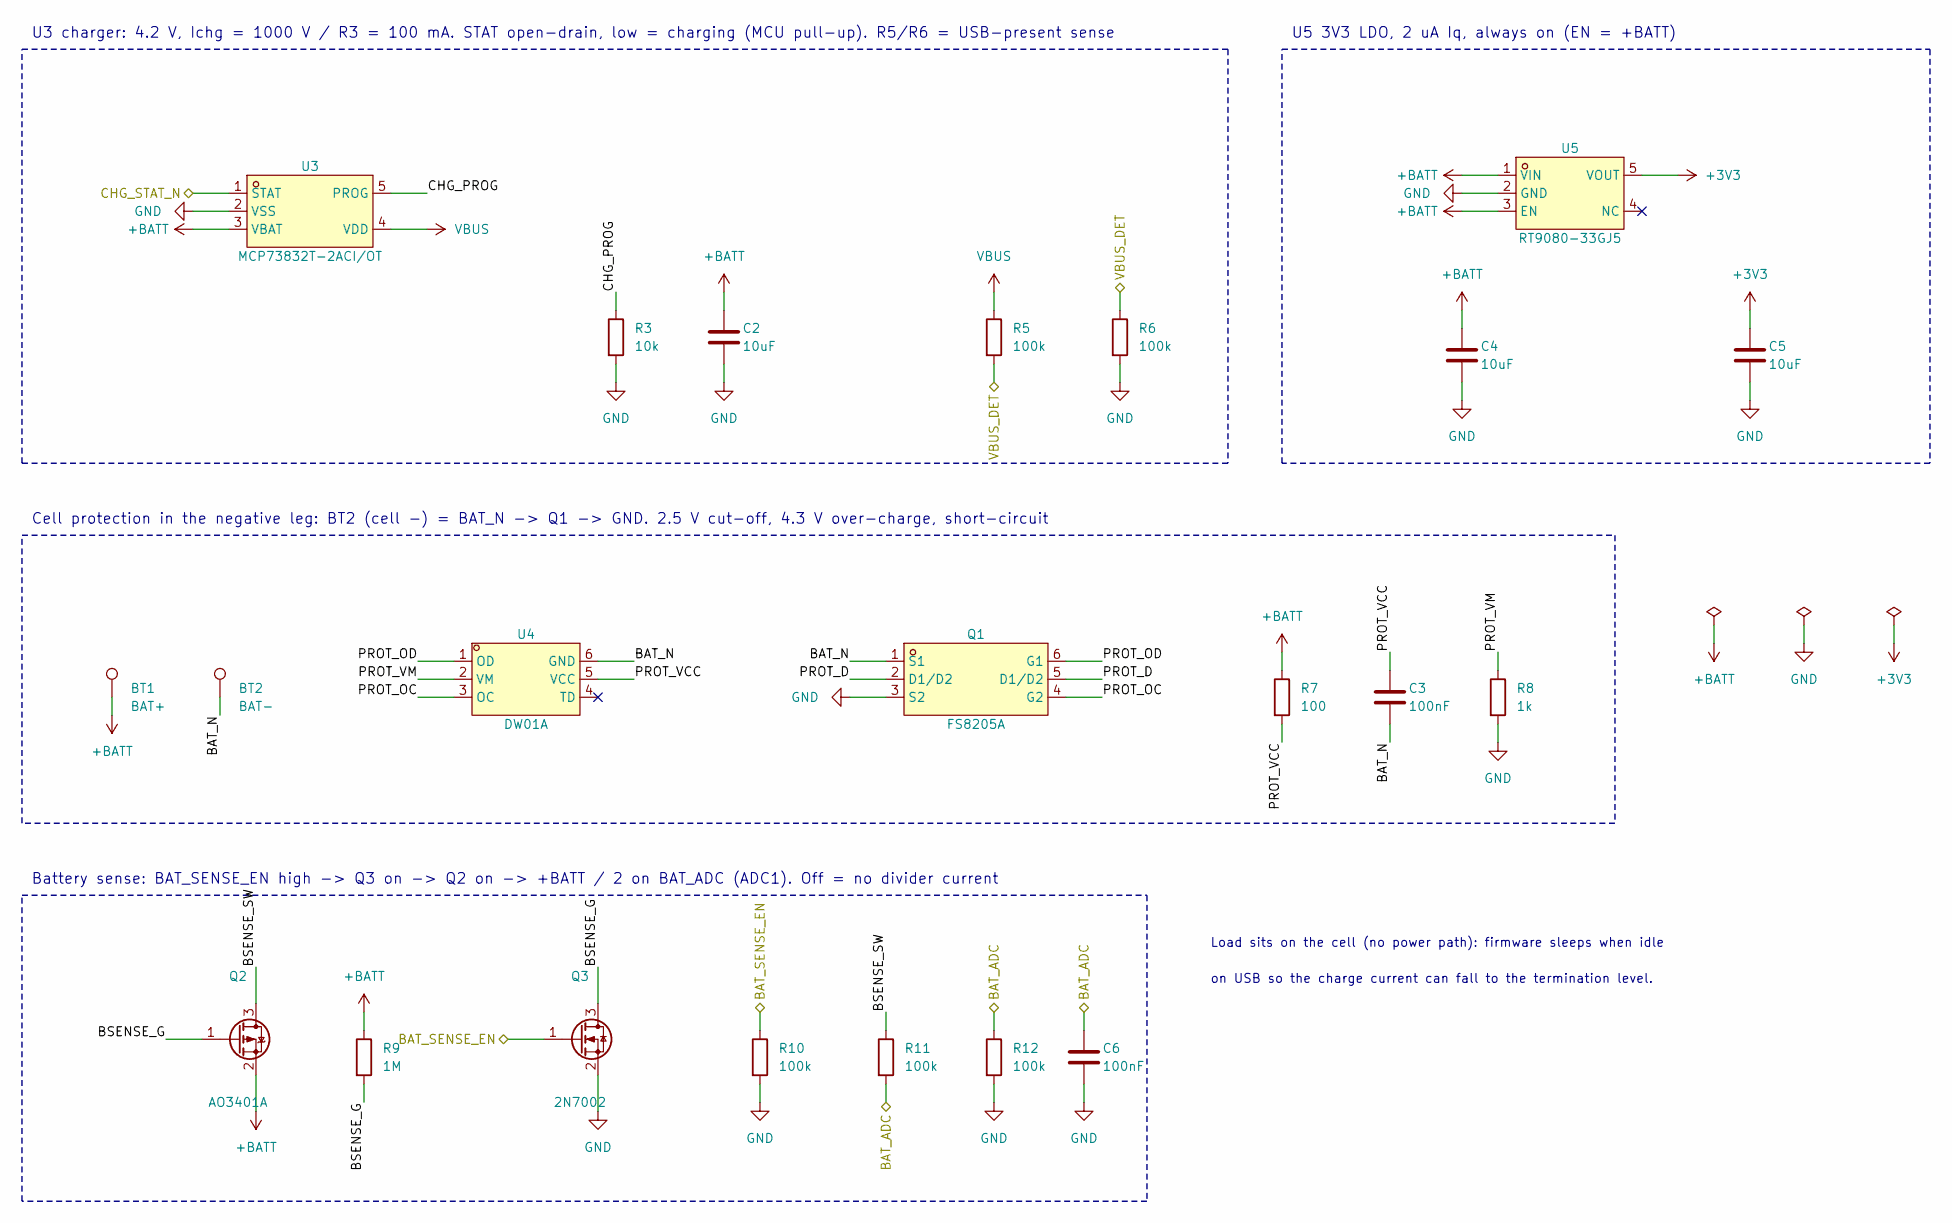
[picture p23: schematic power.kicad_sch, smart-bookmark-esp32s3 - Charger, cell protection, 3V3 LDO,…]

Parts:
BT1: BAT+; TestPoint_Pad_2.5x2.5mm
BT2: BAT-; TestPoint_Pad_2.5x2.5mm
C2, C4, C5: 10uF; C_0603_1608Metric; MPN CL10A106KP8NNNC; LCSC C19702
C3, C6: 100nF; C_0402_1005Metric; MPN CL05B104KO5NNNC; LCSC C1525
Q1: FS8205A; SOT-23-6; MPN FS8205A; LCSC C908265
Q2: AO3401A; SOT-23; MPN AO3401A; LCSC C15127
Q3: 2N7002; SOT-23; MPN 2N7002; LCSC C8545
R3: 10k; R_0402_1005Metric; MPN 0402WGF1002TCE; LCSC C25744
R5, R6, R10, R11, R12: 100k; R_0402_1005Metric; MPN 0402WGF1003TCE; LCSC C25741
R7: 100; R_0402_1005Metric; MPN 0402WGF1000TCE; LCSC C25076
R8: 1k; R_0402_1005Metric; MPN 0402WGF1001TCE; LCSC C11702
R9: 1M; R_0402_1005Metric; MPN 0402WGF1004TCE; LCSC C26083
U3: MCP73832T-2ACI/OT; SOT-23-5; MPN MCP73832T-2ACI/OT; LCSC C38066
U4: DW01A; SOT-23-6; MPN DW01A; LCSC C351410
U5: RT9080-33GJ5; TSOT-23-5; MPN RT9080-33GJ5; LCSC C841192

Connections:
+3V3: C5.1, U5.5 (VOUT); also elsewhere on the board
+BATT: BT1.1, C2.1, C4.1, Q2.2 (S), R7.1, R9.1, U3.3 (VBAT), U5.1 (VIN), U5.3 (EN); also elsewhere on the board
/BAT_ADC: C6.1, R11.2, R12.1; also elsewhere on the board
/BAT_SENSE_EN: Q3.1 (G), R10.1; also elsewhere on the board
/CHG_STAT_N: U3.1 (STAT); also elsewhere on the board
/VBUS_DET: R5.2, R6.1; also elsewhere on the board
/power/BAT_N: BT2.1, C3.2, Q1.1 (S1), U4.6 (GND)
/power/BSENSE_G: Q2.1 (G), Q3.3 (D), R9.2
/power/BSENSE_SW: Q2.3 (D), R11.1
/power/CHG_PROG: R3.1, U3.5 (PROG)
/power/PROT_D: Q1.2 (D1/D2), Q1.5 (D1/D2)
/power/PROT_OC: Q1.4 (G2), U4.3 (OC)
/power/PROT_OD: Q1.6 (G1), U4.1 (OD)
/power/PROT_VCC: C3.1, R7.2, U4.5 (VCC)
/power/PROT_VM: R8.1, U4.2 (VM)
GND: C2.2, C4.2, C5.2, C6.2, Q1.3 (S2), Q3.2 (S), R3.2, R6.2, R8.2, R10.2, R12.2, U3.2 (VSS), U5.2 (GND); also elsewhere on the board
VBUS: R5.1, U3.4 (VDD); also elsewhere on the board

Notes on the sheet:
U3 charger: 4.2 V, Ichg = 1000 V / R3 = 100 mA. STAT open-drain, low = charging (MCU pull-up). R5/R6 = USB-present sense
U5 3V3 LDO, 2 uA Iq, always on (EN = +BATT)
Cell protection in the negative leg: BT2 (cell -) = BAT_N -> Q1 -> GND. 2.5 V cut-off, 4.3 V over-charge, short-circuit
Battery sense: BAT_SENSE_EN high -> Q3 on -> Q2 on -> +BATT / 2 on BAT_ADC (ADC1). Off = no divider current
Load sits on the cell (no power path): firmware sleeps when idle
on USB so the charge current can fall to the termination level.

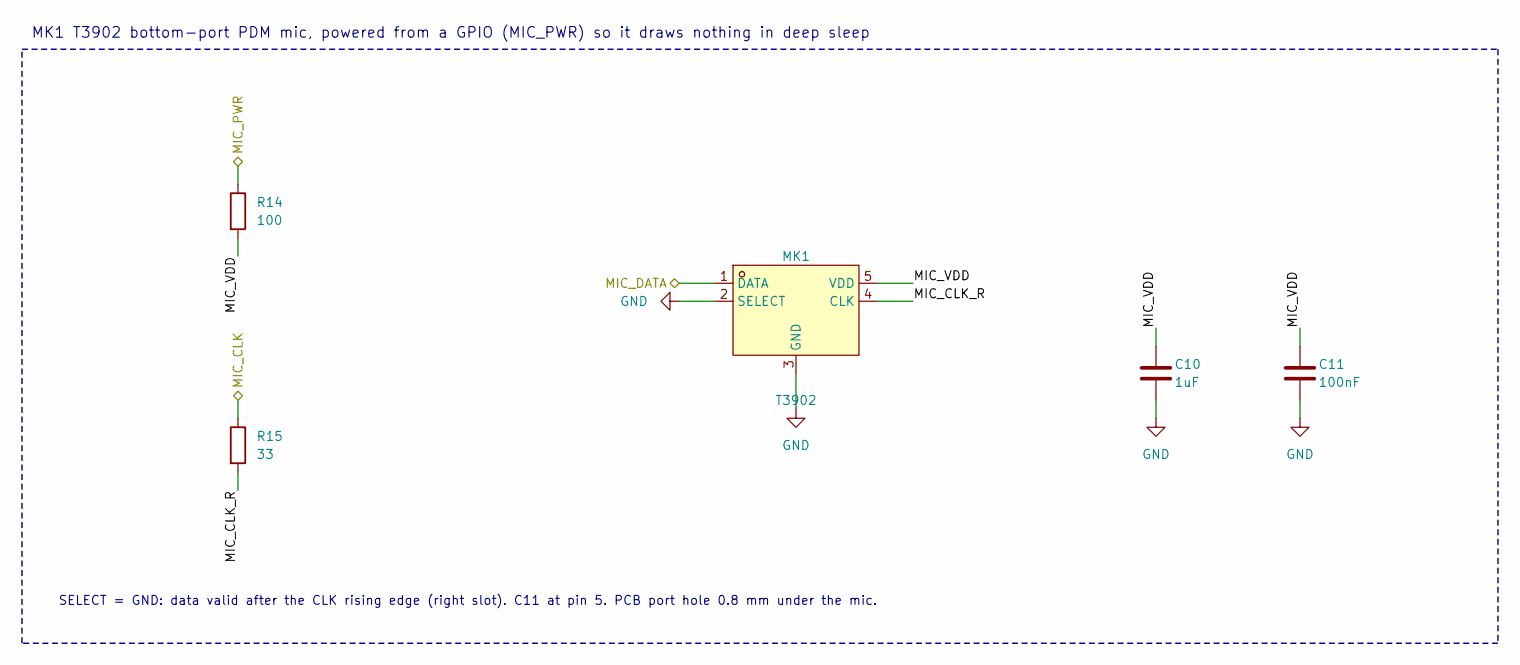
[picture p24: schematic audio.kicad_sch, smart-bookmark-esp32s3 - PDM MEMS microphone]

Parts:
C10: 1uF; C_0402_1005Metric; MPN CL05A105KA5NQNC; LCSC C52923
C11: 100nF; C_0402_1005Metric; MPN CL05B104KO5NNNC; LCSC C1525
MK1: T3902; MIC-SMD_5P-L3.5-W2.7-TL_MMICT390200012; MPN MMICT390200012; LCSC C3171752
R14: 100; R_0402_1005Metric; MPN 0402WGF1000TCE; LCSC C25076
R15: 33; R_0402_1005Metric; MPN 0402WGF330JTCE; LCSC C25105

Connections:
/MIC_CLK: R15.1; also elsewhere on the board
/MIC_DATA: MK1.1 (DATA); also elsewhere on the board
/MIC_PWR: R14.1; also elsewhere on the board
/audio/MIC_CLK_R: MK1.4 (CLK), R15.2
/audio/MIC_VDD: C10.1, C11.1, MK1.5 (VDD), R14.2
GND: C10.2, C11.2, MK1.2 (SELECT), MK1.3 (GND); also elsewhere on the board

Notes on the sheet:
MK1 T3902 bottom-port PDM mic, powered from a GPIO (MIC_PWR) so it draws nothing in deep sleep
SELECT = GND: data valid after the CLK rising edge (right slot). C11 at pin 5. PCB port hole 0.8 mm under the mic.

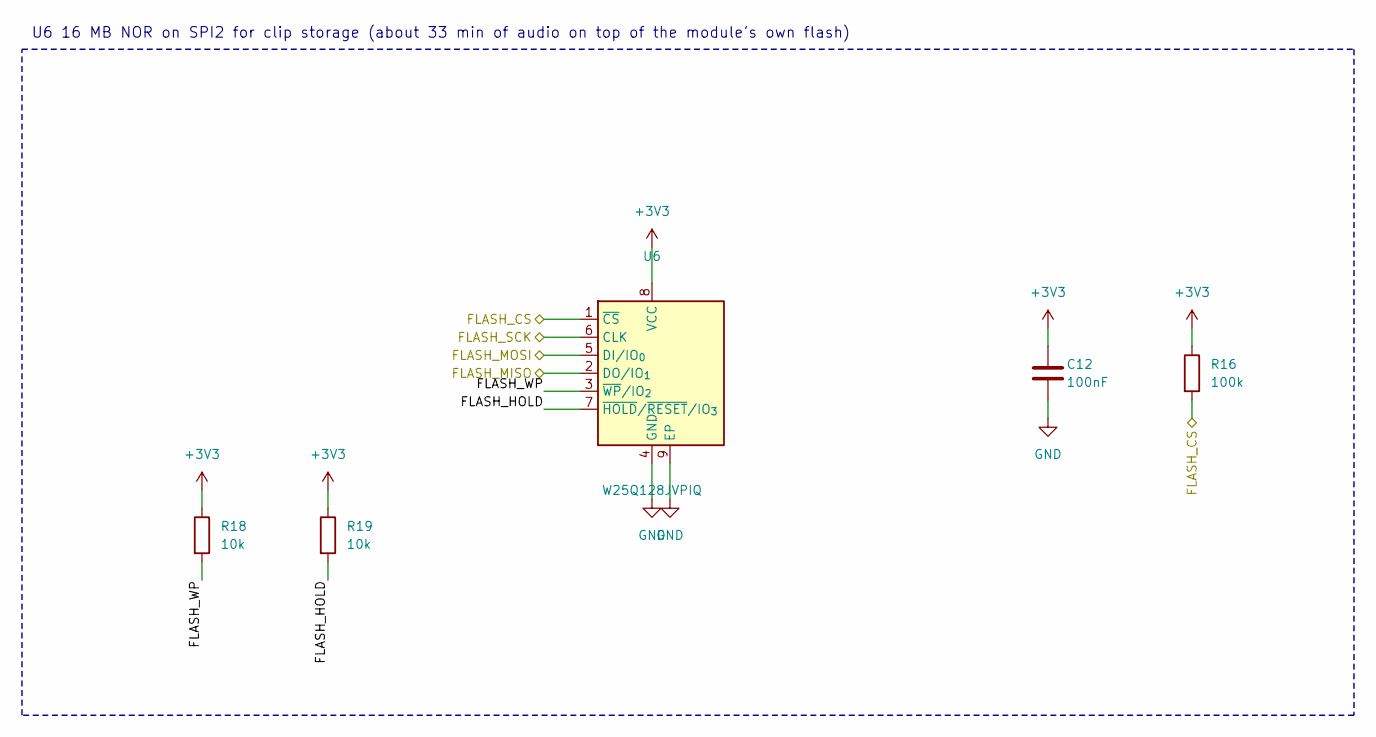
[picture p25: schematic storage.kicad_sch, smart-bookmark-esp32s3 - External 16 MB SPI flash for clips]

Parts:
C12: 100nF; C_0402_1005Metric; MPN CL05B104KO5NNNC; LCSC C1525
R16: 100k; R_0402_1005Metric; MPN 0402WGF1003TCE; LCSC C25741
R18, R19: 10k; R_0402_1005Metric; MPN 0402WGF1002TCE; LCSC C25744
U6: W25Q128JVPIQ; WSON-8-1EP_6x5mm_P1.27mm_EP3.4x4.3mm; MPN W25Q128JVPIQ; LCSC C190862

Connections:
+3V3: C12.1, R16.1, R18.1, R19.1, U6.8 (VCC); also elsewhere on the board
/FLASH_CS: R16.2, U6.1 (~CS); also elsewhere on the board
/FLASH_MISO: U6.2 (DO/IO_{1}); also elsewhere on the board
/FLASH_MOSI: U6.5 (DI/IO_{0}); also elsewhere on the board
/FLASH_SCK: U6.6 (CLK); also elsewhere on the board
/storage/FLASH_HOLD: R19.2, U6.7 (~HOLD/~RESET/IO_{3})
/storage/FLASH_WP: R18.2, U6.3 (~WP/IO_{2})
GND: C12.2, U6.4 (GND), U6.9 (EP); also elsewhere on the board

Notes on the sheet:
U6 16 MB NOR on SPI2 for clip storage (about 33 min of audio on top of the module's own flash)

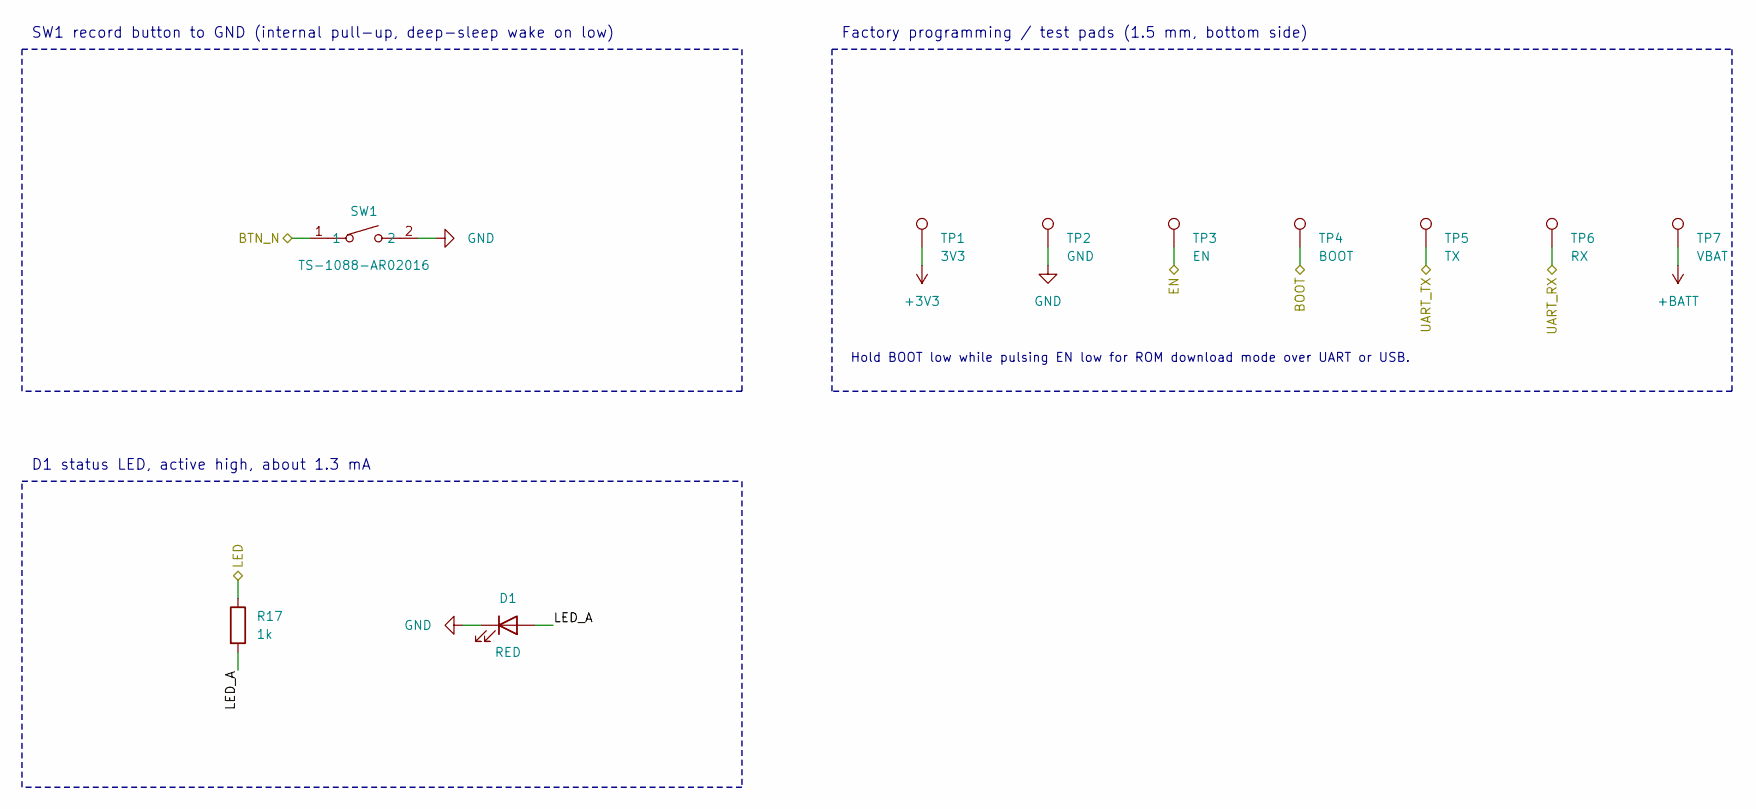
[picture p26: schematic ui_test.kicad_sch, smart-bookmark-esp32s3 - Button, LED, test pads]

Parts:
D1: RED; LED_0603_1608Metric; MPN KT-0603R; LCSC C2286
R17: 1k; R_0402_1005Metric; MPN 0402WGF1001TCE; LCSC C11702
SW1: TS-1088-AR02016; SW-SMD_L3.9-W3.0-P4.45; MPN TS-1088-AR02016; LCSC C720477
TP1: 3V3; TestPoint_Pad_D1.5mm
TP2: GND; TestPoint_Pad_D1.5mm
TP3: EN; TestPoint_Pad_D1.5mm
TP4: BOOT; TestPoint_Pad_D1.5mm
TP5: TX; TestPoint_Pad_D1.5mm
TP6: RX; TestPoint_Pad_D1.5mm
TP7: VBAT; TestPoint_Pad_D1.5mm

Connections:
+3V3: TP1.1; also elsewhere on the board
+BATT: TP7.1; also elsewhere on the board
/BOOT: TP4.1; also elsewhere on the board
/BTN_N: SW1.1; also elsewhere on the board
/EN: TP3.1; also elsewhere on the board
/LED: R17.1; also elsewhere on the board
/UART_RX: TP6.1; also elsewhere on the board
/UART_TX: TP5.1; also elsewhere on the board
/ui_test/LED_A: D1.2 (A), R17.2
GND: D1.1 (K), SW1.2, TP2.1; also elsewhere on the board

Notes on the sheet:
SW1 record button to GND (internal pull-up, deep-sleep wake on low)
D1 status LED, active high, about 1.3 mA
Factory programming / test pads (1.5 mm, bottom side)
Hold BOOT low while pulsing EN low for ROM download mode over UART or USB.

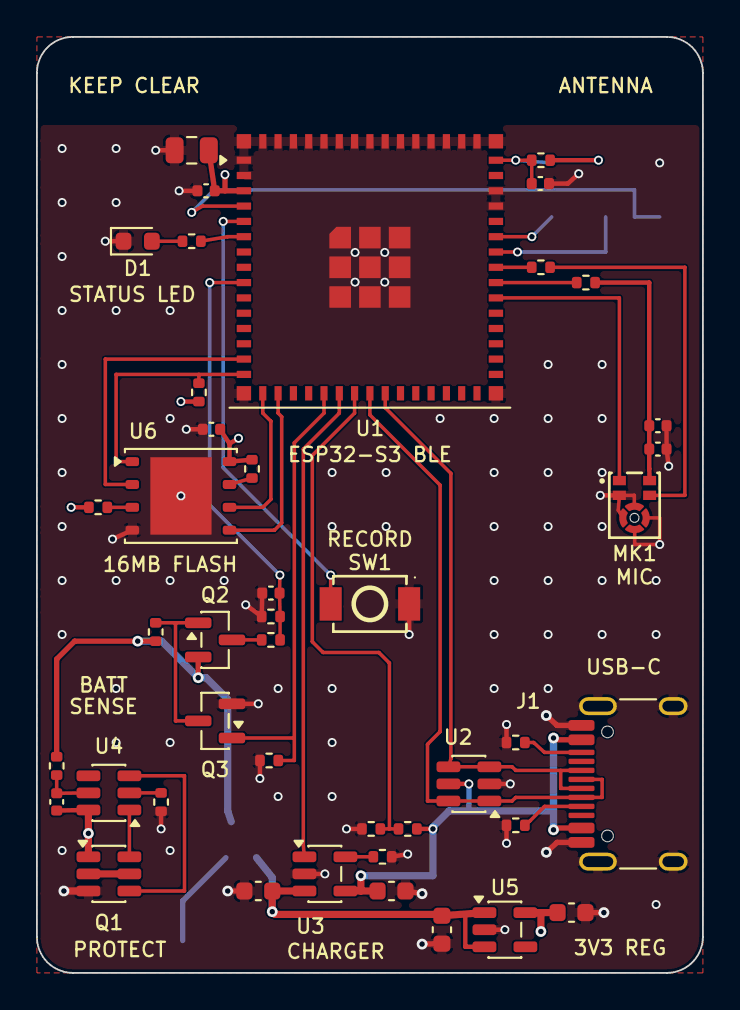
[picture p27: board smart-bookmark-esp32s3.kicad_pcb from above]

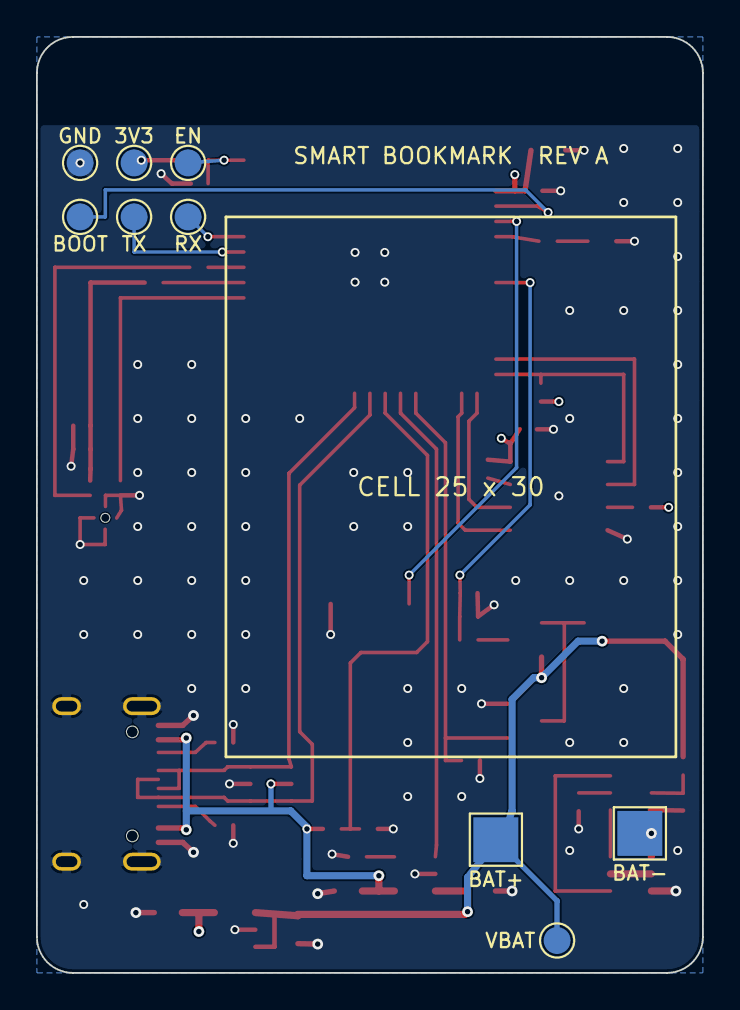
[picture p28: board smart-bookmark-esp32s3.kicad_pcb from below]

Board: 4 copper layers, 37.0 x 52.0 mm, 52 parts (9 on the bottom side), 39 nets.
