xmyoot/smart-bookmark-esp32s3/(commit log)

2026-10-05 Schematic, part libraries and placement for the smart bookmark board
    ESP32-S3-MINI-1-N8, T3902 PDM mic, MCP73832 charger, DW01A/FS8205A protection, RT9080 LDO, USB-C. ERC 0, 153-pin netlist check 0 mismatches. Placement only, not yet routed.
    [audio.kicad_sch, mcu.kicad_sch, power.kicad_sch, smart-bookmark-esp32s3.kicad_pcb, smart-bookmark-esp32s3.kicad_sch, storage.kicad_sch, ui_test.kicad_sch, usb.kicad_sch]
2026-10-05 Add design docs, BLE protocol, proposal draft and firmware source
    Firmware is ESP-IDF (NimBLE, LittleFS, IMA ADPCM) written against the Rev A pin map; not yet built or run on hardware. Pin map revised for a planar layout; R4 removed; stock USB-C footprint.
    [partitions.csv]
2026-10-05 Placement: add missing 3D models, clean up silkscreen
    Module, USB-C and mic now have models; MPN/LCSC fields hidden; designators on silk only for ICs/connectors, passives on Fab; back-side pad labels. Module model offset and J1 label position still need a small nudge.
    [smart-bookmark-esp32s3.kicad_pcb]
2026-10-05 Route the board, DRC clean, JLCPCB fab package
    Hand-routed 4-layer board (GND and +3V3 inner planes). DRC 0 errors, 0 unconnected, 0 parity; two expected lib_footprint_mismatch warnings. Module moved 0.45 mm down (real part is longer than the footprint outline). Mic port hole made non-plated with a footprint-local clearance rule. Gerbers, BOM, CPL, STEP and PDFs in fab/.
    [BOM_JLCPCB.csv, BOM_full.csv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]
2026-10-05 Populate U6 flash, add silkscreen section labels, design brief
    U6 and its passives are now fitted (BOM 24 lines / 43 parts). Top silk names each section; cell outline on the back. docs/designBrief.html generated. ERC and DRC unchanged: 0 errors. Firmware does not use U6 yet.
    [BOM_JLCPCB.csv, BOM_full.csv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]
2026-10-05 Firmware: use external flash U6; proposal; client delivery package script
    Clips go to U6 first and overflow to the module flash; U6 is put in deep power-down before sleep. Builds clean (ESP-IDF 6.1.0), untested on hardware. Proposal rewritten with pricing and timeline. scripts/make_delivery.py builds delivery/ (ignored by git).
2026-10-05 Slim the client delivery package to schematic, PCB, fab, firmware and core docs
